Aryeh95/PaperAir/enclosure/README.md

# Enclosures

Three ways to house the PaperDIY with the sensors:

- **[Saddle](#saddle)** (recommended): the PaperDIY in M5Stack's own case, standing in a one-piece
  saddle with the sensors in a foot behind it. M5Stack's parts do all the fitting of the panel,
  board and buttons.
- **[Slim frame](#slim-frame)**: for the bare board and panel, without M5Stack's case. A thin
  printed frame around the screen. It fits the panel, but its built-in buttons never came right.
- **[Desk stand](#desk-stand)**: a low base that the cased PaperDIY stands in. Bulkier than the
  saddle.

Both need `kFlipScreen = true` in `include/config.h`, because the PaperDIY's buttons end up on top.

## Saddle

The PaperDIY in M5Stack's case, assembled the normal way, slides down into two rails at the
saddle's ends and leans back 13° against it, with a foot behind. Each rail is an end wall and a
2.5 mm flange over the bezel's face, 25 mm up from the bottom: the flanges stop the case tipping,
the end walls stop it sliding, gravity does the rest. Nothing screws the case to the saddle. The
rails' end walls are 3.2 mm thick. The left one has a groove inside for the power button's cap,
which it covers (the firmware doesn't use that button); the USB-C is above the rails. The foot is open underneath and closed by a bottom plate screwed on under the
whole saddle: the SEN66 goes in from below onto two posts on the plate, behind two grilles; the
SFA40 sits in a recess behind its own grille; the breakout goes between the four bosses the plate
screws to. Stick-on rubber feet under the plate. 127 × 44 × 65 mm with the case in it.

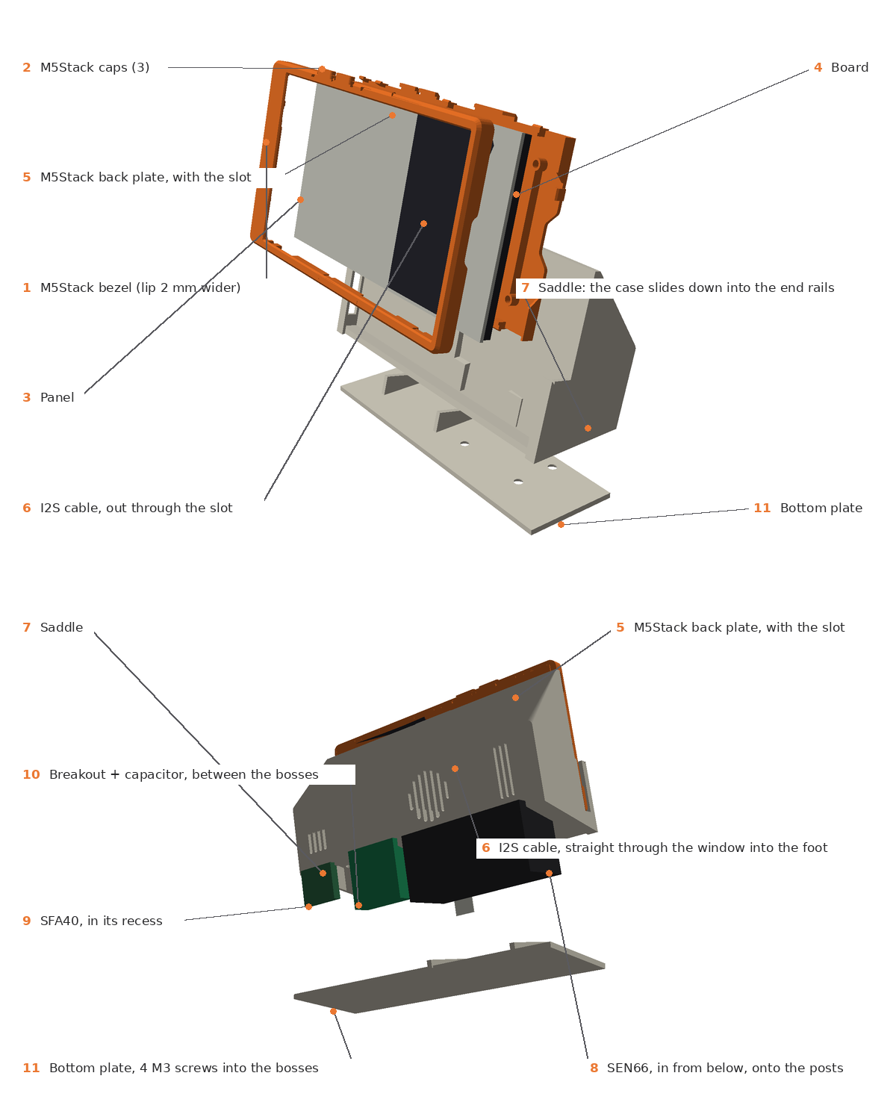
[picture p7: enclosure/render_saddle.png]
Exploded: the case front to back, and the saddle from behind with the foot's contents drawn out


| File | Print | Notes |
|---|---|---|
| M5Stack's three button caps | As M5Stack's | From [M5_Hardware](https://github.com/m5stack/M5_Hardware/tree/master/Products/K159-B_PaperDIY_Complete_Kit/Structures) (MIT licence, © M5Stack), unchanged |
| M5Stack's bezel, with a wider lip | Face down | `make_saddle.py --oem` also writes `paperdiy_bezel_lip.stl`: the lip reaches 2 mm further in all round, so the panel's black border stays covered. 18 pixels of the picture's margin go under it; the layout keeps 40 clear. The stock bezel works too, with a thin line of border showing. |
| M5Stack's back plate, with a slot | As M5Stack's | `python make_saddle.py --out stl --oem PaperDlY_Complete_Kit.stl` cuts an 11 × 14 mm slot over the board's I2S connector, so the FPC cable leaves straight out the back |
| `stl/saddle.stl` | Standing on its bottom edges, as exported | No supports: everything stands on the bed or grows from a wall at 45° or steeper. Four bosses inside the foot take M3 × 3 heat-set inserts (4.0 mm holes) from below. |
| `stl/saddle_bottom.stl` | As exported, posts up | No supports. The bottom plate: four M3 × 6 (or 8) countersunk screws into the bosses. Flat underneath for stick-on rubber feet. |

**Assembly:** press the four M3 × 3 inserts into the bosses inside the foot, from below. Build
M5Stack's case the way they do, bezel face down: caps in, panel in, board on, with the FPC cable
plugged into the I2S connector (the one at the board's inner edge, 5–15 mm from the buttons' edge)
and led out through the slot, then the back plate clipped on. Slide the case down into the rails,
buttons up, feeding the cable through the window in the saddle's face, which is straight behind the
slot, into the foot. Turn the whole thing over to load the foot: stick the SFA40 into its recess (can over the
grille) and the breakout to the back wall between the bosses, wire them as in [Wiring](#wiring),
then lay the SEN66 in between the end fins, grilles toward the back wall, and screw the bottom
plate on; its two posts hold the SEN66 up against the ledge. Stick rubber feet under the plate. Set `kFlipScreen = true`.

## Slim frame

The slim frame: front, back, with the back removed, and a section through the SEN66

- **Screen:** the panel sits behind a printed lip with no acrylic. The lip overlaps the picture by
  0.5 mm top and bottom and 0.3 mm at the ends (inside the screen's own margin), so none of the
  panel's black border shows. Small stops at the corners hold the glass in place.
- **Board:** sits behind the right-hand end of the glass and reaches 4.5 mm past it. Its end rests
  against the right-hand wall, and its two nubs sit in recesses that locate it across.
  - **Buttons:** G4 and G3 are pressed through two fingers in the top wall's outer skin, 8 mm long
    and fixed at one end, with a pad outside and a nub inside. About 0.7 N to click. No loose parts.
  - **Power switch:** the same, in the right-hand wall.
  - **USB-C:** opening on the right end, near the top.
- **Foot:** at the bottom-back, 28.5 mm deep, with a 45° shoulder up to the back plate. It holds:
  - **SEN66:** behind the left half of the glass, breathing through two grilles in the back.
  - **SFA40:** in a shallow recess in the back wall, behind the board, with its own grille.
  - **FPC breakout, its capacitor and the battery:** behind the board too, through an opening in
    the back plate there.
- **Board:** backed by the plate along its top edge and down its right-hand end, with foam tape
  between. The rest of the plate behind it is the opening into the foot.
- **Cable:** the FPC cable runs down inside, along the board's inner edge.
- **Sizes:** 125 wide × 68 tall × 36 deep. The screen part is 9 mm thick.

### Parts

| File | Print | Notes |
|---|---|---|
| `stl/frame_fit_test.stl` | **Print this first**, face down as exported | About an hour. See the checks below. |
| `stl/frame_bezel.stl` | Face down, as exported | No supports |
| `stl/frame_back.stl` | Standing on its bottom face, as exported | No supports. The bottom face is the flat one that sits on the desk; the split face is vertical. Nothing overhangs more than 45°. |
| `stl/frame_backer.stl` | Flat, as exported | Backing plate. The panel is flexible, so this holds it flat against the lip. It drops in; two ribs on the back hold it. |

### Fit test

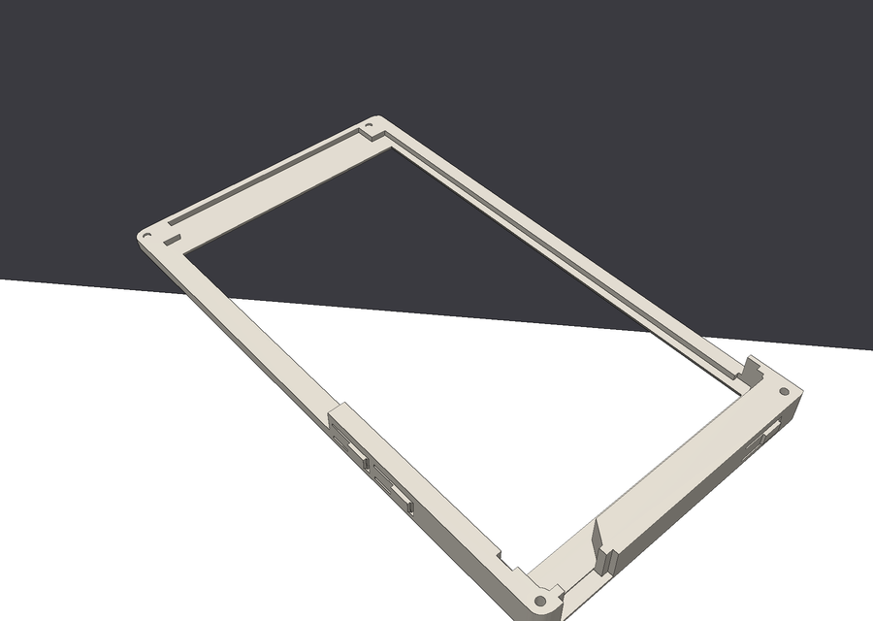
[picture p8: enclosure/render_fit_test.png]
The fit test as printed: a ring of the bezel's first 2.4 mm, full depth along the top and the right end


Drop the plugged-together panel and board into it, face down, then check:

1. **Pocket:** the glass drops in without forcing, with its left end between the two stops, and
   doesn't move. It has 0.25 mm to spare at each end and 0.15 above and below. Near the right end,
   the board has a small nub on each long edge. Each nub sits in its own recess, and the board's end
   touches the right-hand wall.
2. **Lip:** from the front, the lip covers the glass edge on all four sides but none of the
   picture beyond its outermost 5 pixels. Press G3 to flash the screen black and look at the
   edges. The picture is 4 mm from the glass's flex end and 1.5 mm from its board end, so the lip
   is wider on the left.
3. **Buttons:** press each of the three pads. Each should click its switch with a light press and
   spring back, and the screen shouldn't change unless you press. If a pad has to go in a long way
   before it clicks, the nub is short; if it clicks with no travel, it's long (`KEY_TIP_Y`,
   `PWR_TIP_X`).
4. **USB-C:** a cable plugs in fully.

If anything is off, tell me what you see, or change the measurement constants at the top of
`make_frame.py`. Each is labelled.

### Hardware

| Qty | Part |
|---|---|
| 4 | M2 × 6 screws, thread-forming ("PT") or plain M2 (they cut their own thread in the printed holes). The bottom-right one has no counterbore; its head stands proud. |
| 4 | 10 mm round rubber feet, 2 mm thick |
| — | Double-sided foam tape: 2 mm for a strip down the back of the board (it compresses to 1.7), 1 mm for the SFA40 board and the breakout |
| 1 | FPC cable, 12-way 0.5 mm, 150 mm, the same as for the stand, plus the breakout and capacitor (see Wiring) |

### Assembly

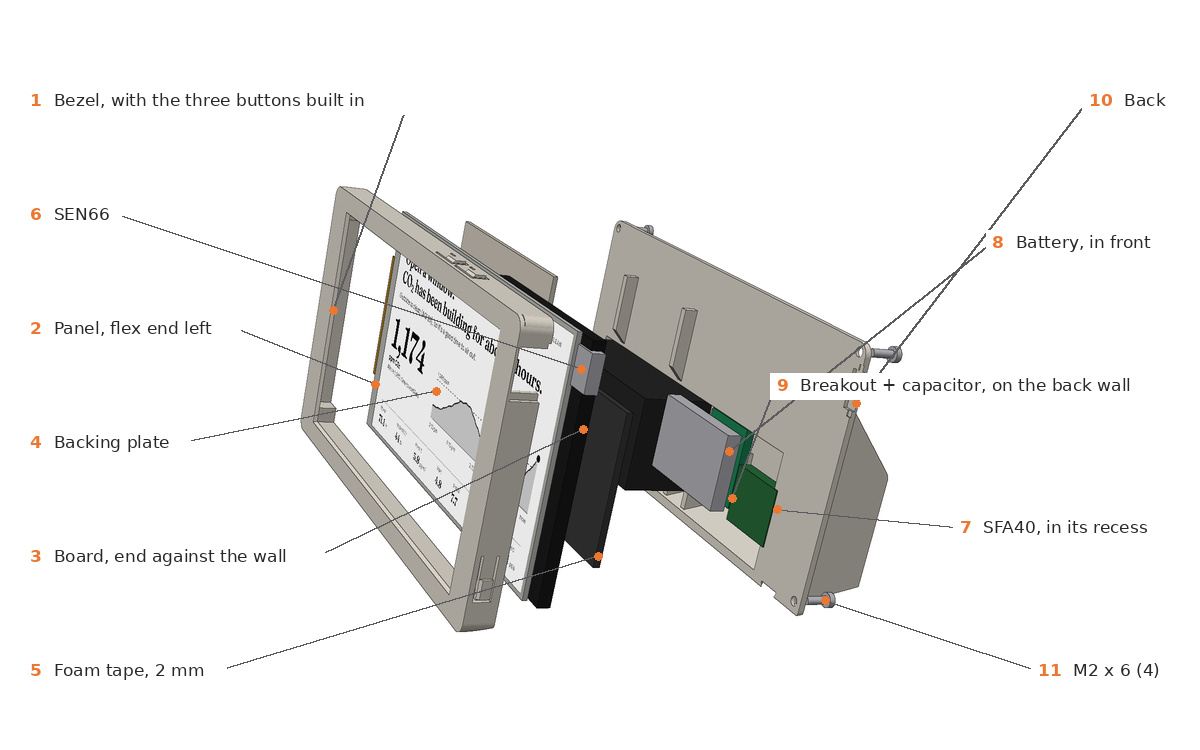
[picture p9: enclosure/render_exploded.png]
Exploded view: bezel and caps, panel and board, backing plate and foam tape, then the sensors, battery and breakout inside the back


1. Lay the panel face down in the bezel, with the board on the right-hand end. Plug the FPC cable
   into the board's FPC-I2S socket and the battery into its socket.
2. Drop the backing plate in behind the panel, left of the board, with its shallow channel over
   the panel's flex strip. It's loose until the back goes on; two ribs on the back then hold it
   against the panel.
3. Foam tape on the back of the board, 2 mm, in an L: a strip along its top edge and one down its
   right-hand end, on the tallest parts there (that's what the 4.7 mm stack was measured over). The
   back plate compresses it to 1.7 mm, which holds the board against the glass. Push the board's end
   against the right-hand wall before closing up: that's what lines its buttons up with their caps.
4. In the back part, deepest first:
   - Solder four wires to the SFA40's carrier board, then stick it into its recess in the back wall,
     can over the grille, solder pads toward the SEN66. It goes in through the opening behind the
     board.
   - Stick the breakout to the back wall beside it, capacitor already soldered across 3V3 and GND.
   - Lay the battery in the opening in front of them.
   - Slide the SEN66 in from the front: bottom edge onto the two fins, between the end fins, grilles
     against the back wall. Its top edge sits under the plate's edge and in the corner of the roof.
5. Run the FPC cable down along the board's inner edge, in the gap in front of the back plate, and
   into the opening to the breakout. Wire the sensors (see Wiring).
6. Close the back and fit the four screws. Stick the feet into their recesses.

The stiff part of the panel's flex reaches about 5 mm past the glass's left end. It lies flat between
the two stops at the left-hand corners, with room before the wall, and the flex loops up from it and
over the back of the panel to the board. The stops, and two at the right-hand corners, hold the glass
in place along its length. The board is a separate part, joined to the panel only by the flex, and
rests with its end against the right-hand wall.

### Measured, and worth checking

Most of the numbers come from M5Stack's dimension drawings of the panel, the board and the case,
and from the case model in
[M5_Hardware](https://github.com/m5stack/M5_Hardware/tree/master/Products/K159-B_PaperDIY_Complete_Kit),
checked against fit-test prints:
- the board's end, 4.46 mm past the glass, and its button, USB-C and power switch positions,
  measured from that end
- the two nubs on the board's long edges. They make it 64.2 mm across, against 62 mm for the glass
  (`NUBS_X`, `NUB_OUT`).
- the board's end: a tab at each corner stands proud of a recess between them, with 45° steps
  (calipers). The USB-C tab is 15 wide and 4 proud; the power-switch tab 15 wide and 3 proud. The
  USB-C tab is what rests against the end wall (`TAB_*`, `PWR_TAB_*`).
- the panel thickness, 1.2 mm. The backing plate and the ribs that hold it are set from it
  (`GLASS_T`).

From calipers and the fit tests:
- the glass, 110.5 × 62 mm (the drawing says 62.5; if yours is, `GLASS_H` in `make_frame.py`)
- the picture's position on the glass: 4 mm from the flex end, 1.5 mm from the board end
  (`ACTIVE_X`). This is the one to check first if the lip covers the picture or shows the border.
- the board's inner edge, and how far the button actuators stick out

The fit test checks all of them. The constants are at the top of `make_frame.py`.

## Desk stand

A low base that the PaperDIY stands in, leaning back 12°, with the SEN66 and the optional SFA40
inside it.

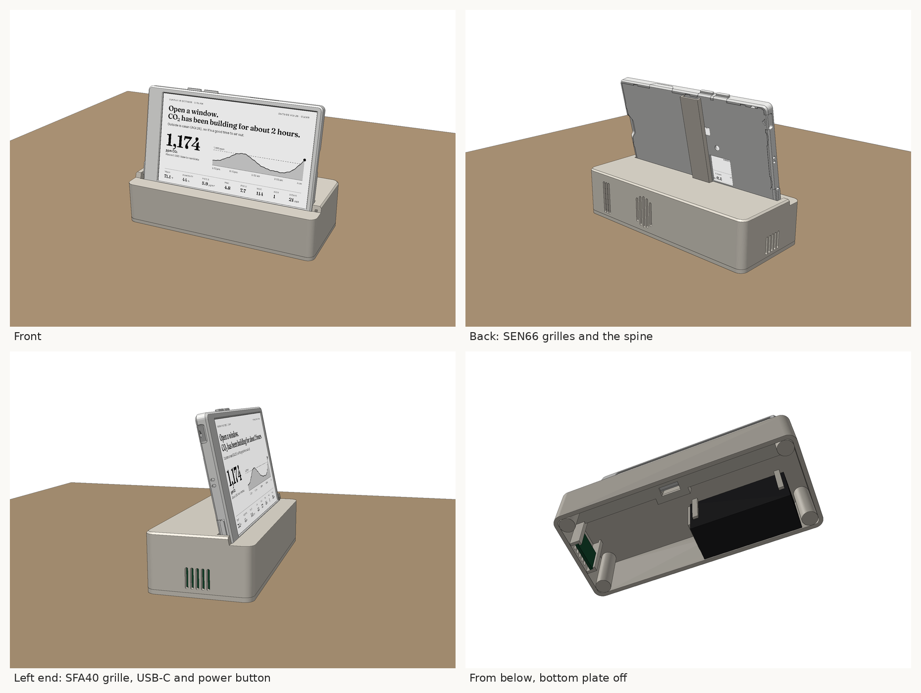
[picture p10: enclosure/render.png]
The stand: front, back, left end, and from below with the bottom plate off


- **The PaperDIY stands upside down** compared with how it ships, so its two buttons are on the
  top edge. The USB-C port and the power button end up on the left end. Set `kFlipScreen` in
  `include/config.h` if the picture comes out upside down.
  - Left button on the top edge: G3, full refresh.
  - Right button on the top edge: G4, switches between the main and trends pages.
- **The SEN66** lies against the back wall. It breathes through two grilles: the inlet at the right
  and the fan outlet in the middle. The solid wall between them keeps outlet air out of the inlet.
- **The SFA40** slides into a bay at the left end, sensor facing the small grille. It works by
  diffusion, so it needs no fan.
- **The FPC cable** connects the PaperDIY to the sensors:
  1. It leaves the PaperDIY through a slot in its back plate.
  2. It runs down a groove behind the PaperDIY, hidden by the spine.
  3. It drops through a hole in the slot floor into the base, where the breakout board sits loose
     in the front-left corner.
- **The front of the base steps down,** so the base doesn't hide the bottom row of readings.

Sizes: base 132 × 56 × 32 mm; with the PaperDIY in it, 91 mm tall.

### Parts

| File | Print | Notes |
|---|---|---|
| `stl/stand_base.stl` | Upside down, as exported | Turn on supports **touching the build plate only**. They're needed only under the 4 mm step at the front. Everything else (grilles, slot, ribs) prints without them. |
| `stl/stand_bottom.stl` | Flat, as exported | Countersunk holes and foot recesses face the bed |
| `stl/stand_spine.stl` | Flat on its back, as exported | Push it into the socket behind the slot. A drop of glue is optional. |
| back plate with FPC slot | Floor down, like M5Stack's | Generated from M5Stack's model; see below |

**Back plate.** Make it with
`python make_stand.py --out stl --oem PaperDlY_Complete_Kit.stl`, using M5Stack's model from
[M5_Hardware](https://github.com/m5stack/M5_Hardware/tree/master/Products/K159-B_PaperDIY_Complete_Kit/Structures)
(MIT licence, © M5Stack).

Alternatively, cut the slot into the back plate you have. It's 1.2 mm thick PLA, so a hobby
knife works. The slot is 5 × 13 mm. Seen from the screen side, with the case as it ships (buttons
on the bottom edge):
- 63.5–68.5 mm from the left edge
- 47.5–60.5 mm from the top edge

**Check the slot position before printing or cutting.** I worked it out from M5Stack's pinmap
photo, which I scaled using the ESP32 module. The board's other parts line up with the back
plate's windows to within about 1.5 mm. With the back off, the FPC-I2S connector should be 71–76 mm
from the left and 49–59 mm from the top, with its cable leaving towards the left. If yours is
elsewhere, change `BACKPLATE_SLOT` in `make_stand.py`.

### Hardware

| Qty | Part |
|---|---|
| 4 | M3 × 5.7 heat-set insert (4.4 mm holes, into the base's corner bosses from below) |
| 4 | M3 × 8 countersunk screw (bottom plate) |
| 4 | 10 mm round rubber feet (optional) |
| 1 | FPC cable, 12-way, 0.5 mm pitch, 150 mm. Which contact side you need depends on the breakout, so buy one of each ("A", same side, and "B", opposite sides); they're cheap. |
| 1 | FPC breakout board, 12-way 0.5 mm to 2.54 mm pins |
| 1 | 220 µF capacitor, 6.3 V or more (recommended, see below) |

## Wiring

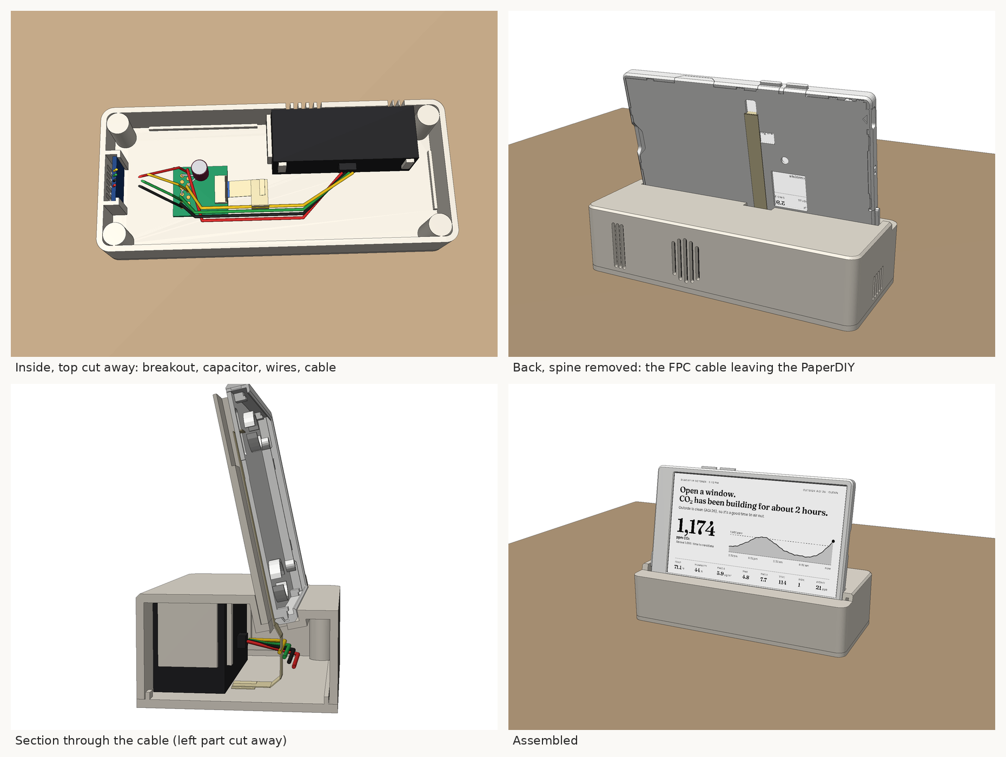
[picture p11: enclosure/render_wiring.png]
Inside the base, the cable route behind the PaperDIY, a section through the cable, and assembled


The cable goes into the **FPC-I2S** connector, the one nearer the buttons. On the PaperDIY's side:

| Pin | Signal | Goes to |
|---|---|---|
| 4 | G41 SYS_SDA | SDA on the SEN66 and SFA40 |
| 5 | G42 SYS_SCL | SCL on both |
| 2, 6 | GND | GND on both |
| 11, 12 | 3V3_AU | VDD on both |

- **Check the breakout's pin numbers before connecting the sensors.** A cable with contacts on
  opposite sides reverses the order.
  1. With the PaperDIY on USB, find the two neighbouring pins that read 3.3 V against a GND pin.
     Those are 11 and 12.
  2. Count the other pins from there.
- **3V3_AU** comes from its own 300 mA regulator, which is on whenever the PaperDIY has power.
  The SEN66 averages about 90 mA, but its fan and CO₂ sensor draw up to 350 mA in 2 ms bursts. So
  solder the 220 µF capacitor across 3V3 and GND on the breakout. Mind the polarity of an
  electrolytic capacitor.
- The bus already has pull-up resistors (it's shared with the PaperDIY's power chip), so the
  sensors need none.

### Changing the stand

Everything is set by the constants at the top of `make_stand.py`:
- the SEN66 and SFA40 sizes
- the slot clearance and lean
- the base size
- the insert hole size
- the back plate slot

Run `python make_stand.py --out stl` after a change (needs `pip install trimesh manifold3d numpy`).
