Aryeh95/PaperAir/preview/starting.png

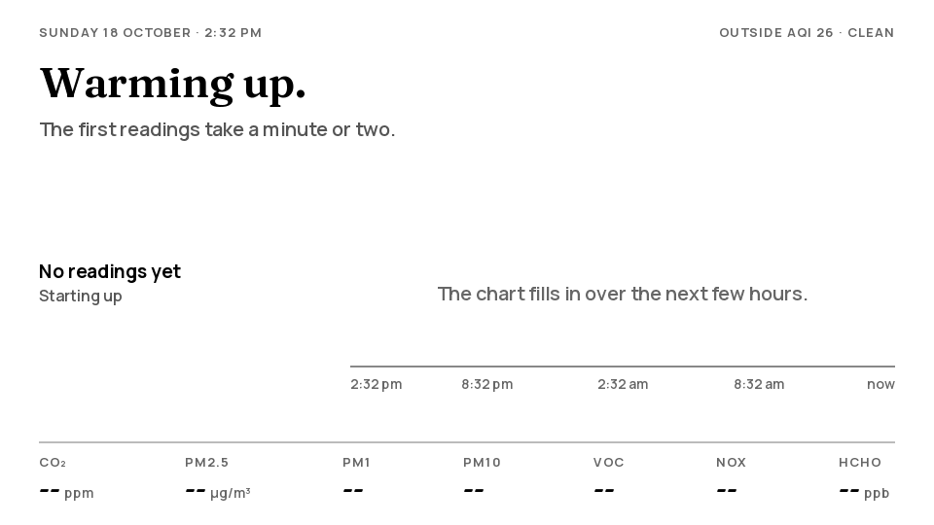
preview/starting.png
