Aryeh95/PaperAir/enclosure/stl/saddle.stl

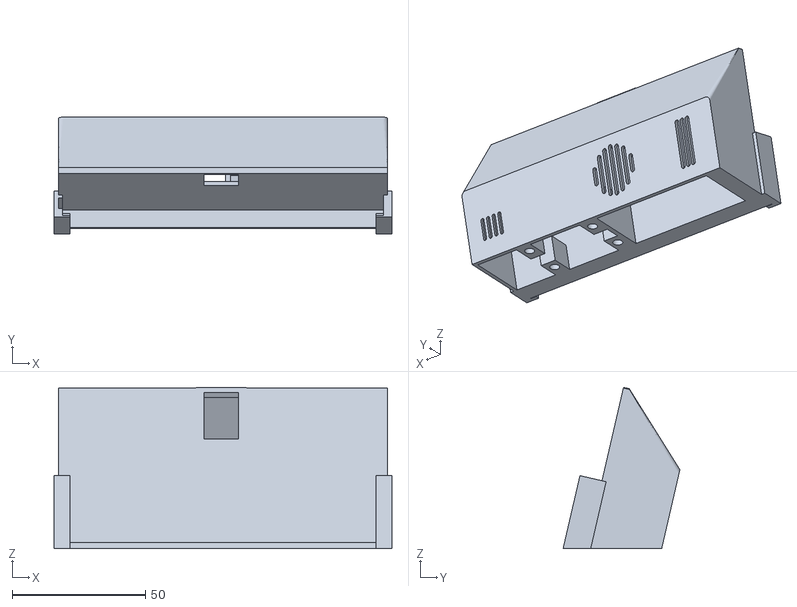
[picture p13: CAD file, 2026-11-10]
enclosure/stl/saddle.stl
127.0 x 43.9 x 60.6
