Aryeh95/PaperAir/enclosure/stl/saddle_bottom.stl

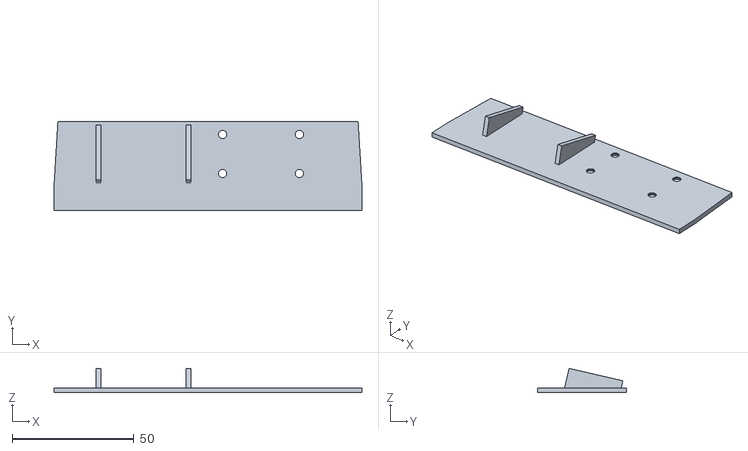
[picture p14: CAD file, 2026-11-10]
enclosure/stl/saddle_bottom.stl
126.4 x 36.4 x 9.96
