Aryeh95/PaperAir/enclosure/stl/frame_fit_test.stl

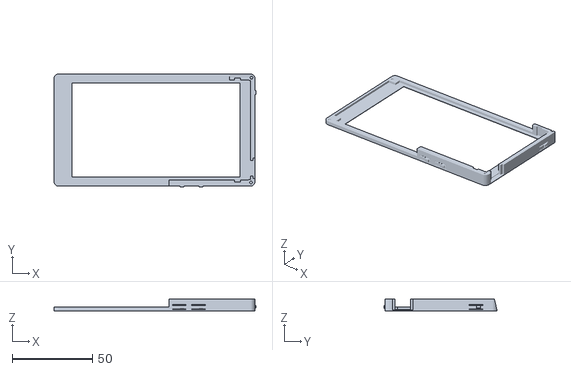
[picture p15: CAD file, 2026-10-28]
enclosure/stl/frame_fit_test.stl
125.8 x 70.6 x 7.40
