Aryeh95/PaperAir/enclosure/stl/frame_bezel.stl

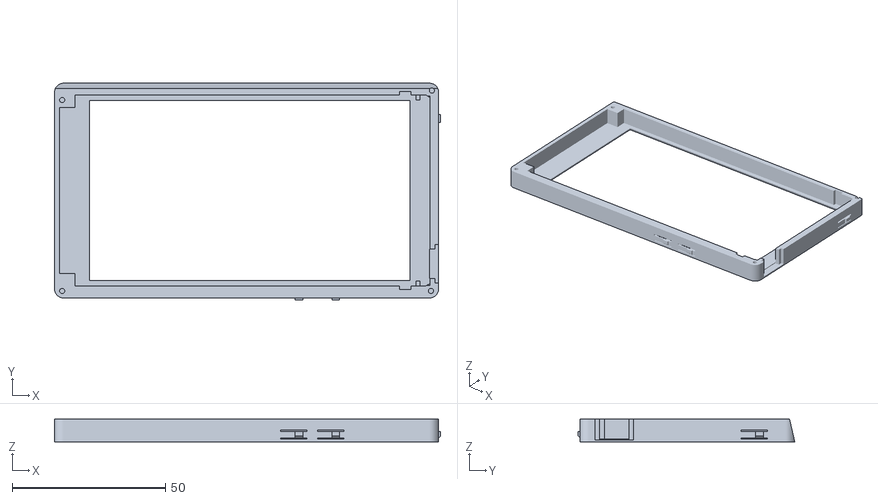
[picture p16: CAD file, 2026-10-28]
enclosure/stl/frame_bezel.stl
125.8 x 70.6 x 7.40
