Aryeh95/PaperAir/enclosure/stl/frame_back.stl

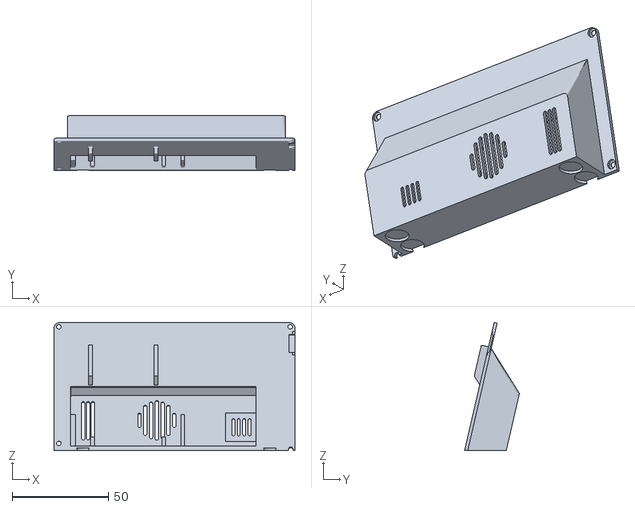
[picture p17: CAD file, 2026-10-28]
enclosure/stl/frame_back.stl
125.2 x 28.5 x 66.5
