Aryeh95/PaperAir/enclosure/stl/frame_backer.stl

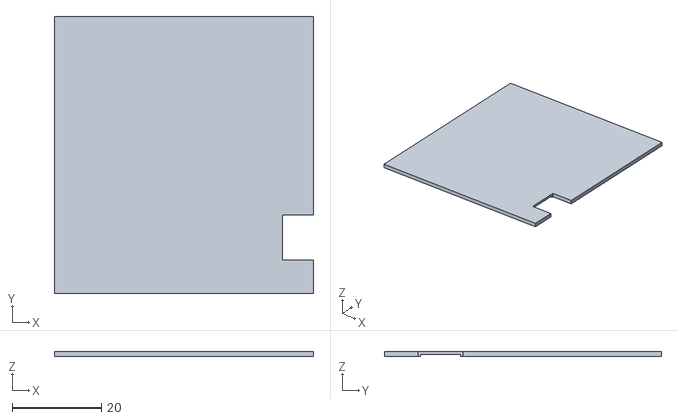
[picture p18: CAD file, 2026-10-28]
enclosure/stl/frame_backer.stl
58.1 x 62.1 x 1.20
