Aryeh95/PaperAir/enclosure/stl/stand_bottom.stl

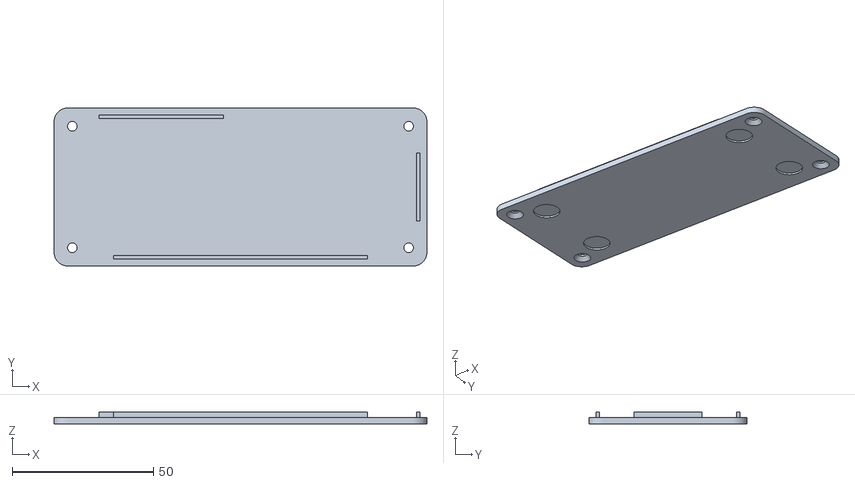
[picture p19: CAD file, 2026-10-18]
enclosure/stl/stand_bottom.stl
132.0 x 56.0 x 4.40
