Aryeh95/PaperAir/enclosure/stl/stand_base.stl

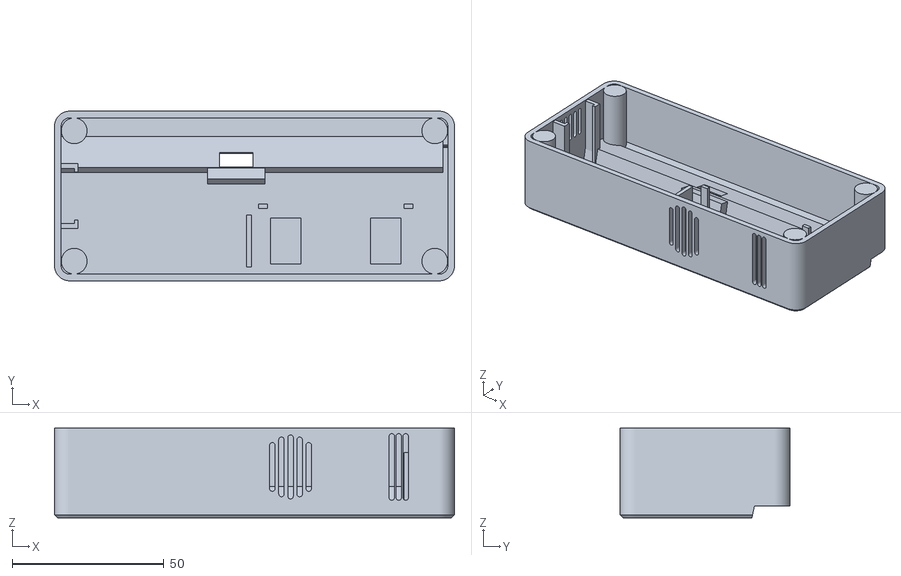
[picture p20: CAD file, 2026-10-18]
enclosure/stl/stand_base.stl
132.0 x 56.0 x 29.6
