Aryeh95/PaperAir/enclosure/stl/stand_spine.stl

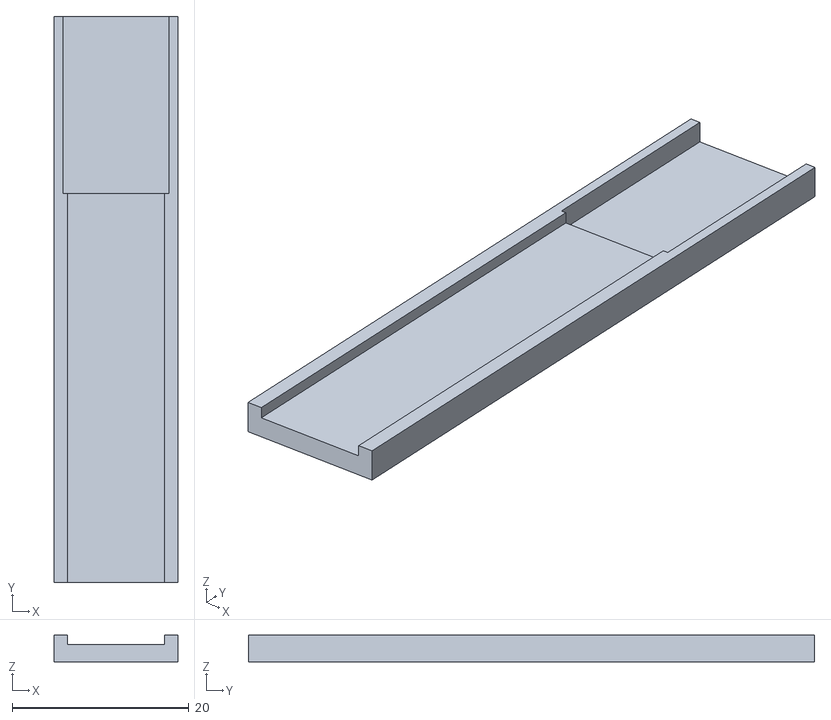
[picture p21: CAD file, 2026-10-18]
enclosure/stl/stand_spine.stl
14.0 x 64.0 x 3.00
