Aryeh95/PaperAir/enclosure/make_saddle.py

"""
Generates the saddle-foot for PaperAir: the PaperDIY in M5Stack's own case stands in it, leaning
back 13 degrees, with the SEN66, the optional SFA40, the FPC breakout and the battery in a foot
behind the case's lower half.

M5Stack's parts are used as they are (bezel, back plate, three button caps; MIT licence, in
M5_Hardware), except that the back plate gets a slot over the board's I2S connector, so the FPC
cable can leave the case. Pass M5Stack's STL with --oem to cut it; nothing of theirs is kept here.

Parts:
  saddle.stl              the saddle, open underneath. Printed standing on its bottom edges, as
                          exported, without supports: every part of it stands on the bed or grows
                          from a wall at 45 degrees or steeper. The assembled case slides down into
                          the two end rails; nothing screws the case to the saddle. The cable
                          window in its face is straight behind the back plate's slot.
  saddle_bottom.stl       the bottom plate, under the whole saddle: the sensors go in through
                          here. Four M3 countersunk screws into M3 x 3 heat-set inserts in the
                          bosses. Carries the two posts the SEN66 rests on. Printed as exported,
                          posts up, without supports.
  paperdiy_back_slot.stl  M5Stack's back plate with the cable slot (only with --oem). Printed as
                          M5Stack's.
  paperdiy_bezel_lip.stl  M5Stack's bezel with its lip 2 mm wider all round (--lip), so the panel's
                          black border stays covered. Printed face down, as exported.

Coordinates (mm), "local": X to the right seen from the front, Y down the screen (0 = the top edge
of the case, where the buttons are), Z into the case (0 = the bezel's front face). The saddle is then
leaned back and cut level where it meets the desk.

Usage:
  pip install trimesh manifold3d numpy
  python make_saddle.py --out stl [--oem PaperDlY_Complete_Kit.stl]
"""

import argparse
import math
import os

import numpy as np
import trimesh
from manifold3d import CrossSection, JoinType, Manifold, Mesh, OpType

SEG = 48

# --- M5Stack's case, from its model: 120 x 67 x 6.3, buttons on one long edge, USB-C on one end ---
CASE = (120.0, 67.0, 6.3)
CLR = 0.3                            # around the case in the saddle
# The I2S cable leaves its connector, passes under the display flex's fold and runs down the back
# of the panel, 5-15 mm from the buttons' edge (photo with the case open). The slot is in the back
# plate over the panel, just past the board's inner edge, so the cable turns straight out the back.
SLOT = (53.9, 64.9, 8.0, 22.0)       # x0, x1, y0, y1
# The same slot in M5Stack's coordinates (their model: buttons at -Y, USB-C at +X, front at Z -0.2)
# M5Stack's model to case coordinates: a half turn about Y. X local = 35.056 - X oem (their +X is
# to the left seen from the front), Y local = Y oem + 58.74, Z local = -(Z oem + 0.2).
OEM_XMAX, OEM_OFFSET = 35.056, (84.94, 58.74, -0.2)

# --- Saddle ---
WALL = 1.6
FRONT = 0.0                          # the floor's front edge: flush with the bezel's face. Nothing may stand in front of
                                     # the bezel, because it clips onto the back plate from the front after the plate is
                                     # screwed to the saddle
# The case is held by two rails at its ends: an end wall and a flange over the bezel's face, up
# from the floor. The assembled case slides down into them from the top; gravity and the 13 degree
# lean keep it against the saddle, the flanges stop it tipping, the end walls stop it sliding.
# The left end (seen from the front) has the USB-C high up, above the rails, and the power
# button's cap low down, which protrudes 1.2 mm: a groove down the inside of the left end wall
# clears it. The groove does not go through, so the wall stays in one piece (the button is covered).
RAIL_H = 25.0                        # up from the case's bottom edge
FLANGE_W, FLANGE_T = 2.5, 1.6        # over the bezel's face at each end (its frame is 3.5 wide at the right end)
RAIL_EXTRA = 1.6                     # the rails' end walls are this much thicker than the foot's, outward: 3.2 mm in all
POWER_CAP = (64.5, 1.5, 5.5)         # y1, z0, z1 of the slot for the power button's cap: open from the rail's top down to y1, so the cap can slide in
FLOOR = 2.4                          # under the case at the front (rubber feet sit in it)
TILT = math.radians(13)
T_THIN = CASE[2] + CLR + 2.4         # the thin part behind the case, at the top of the foot's shoulder
CABLE_BELOW = 4.0                    # the cable window in the face reaches this far below the back plate's slot

# --- Foot ---
SEN = (55.0, 26.0, 21.2)             # SEN66: length (X), width (Y), depth (Z)
SEN_X0 = 6.0
SEN_Z0 = CASE[2] + CLR + WALL + 3.0  # 3 mm in front of it for the cable and wires
T_FOOT = SEN_Z0 + SEN[2] + 0.2 + WALL
SFA = (17.3, 15.2, 3.6)              # SFA40 carrier board, 16.9 x 14.8 x 3.4 measured, plus clearance
SFA_RECESS = 0.6

INSERT_HOLE = 4.0                    # for M3 heat-set inserts

# The bottom plate: 2 mm, screwed on under the whole saddle (everything of the saddle stands on the
# printer's bed, so it prints without supports). Four countersunk M3 screws go up into M3 x 3
# inserts (4.0 mm holes) in four bosses that stand on the bed against the front and back walls, in
# the free space between the SEN66 and the SFA40.
PLATE = 2.0
PLATE_CLR = 0.3                      # the plate's outline, in from the saddle's footprint
BEAM_X = (66.0, 97.5)                # boss centres, 7 wide: between the SEN66 (ends at 61) and the SFA40 (starts at 101.5)
BEAM_W, BOSS_D, BOSS_H = 7.0, 9.0, 10.0
BOTTOM_INSERT_DEPTH = 4.0            # M3 x 3 inserts, with a little room above them
BOTTOM_SCREW_IN = 4.5                # the holes, in from the front and back walls

X0, X1 = -CLR - WALL, CASE[0] + CLR + WALL
Y1 = CASE[1] + CLR + FLOOR           # where the saddle's front-bottom edge meets the desk


# ---------------------------------------------------------------------------------------------
def box(x0, x1, y0, y1, z0, z1):
    return Manifold.cube([x1 - x0, y1 - y0, z1 - z0]).translate([x0, y0, z0])


def rr(x0, x1, y0, y1, r):
    r = min(r, (x1 - x0) / 2 - 0.01, (y1 - y0) / 2 - 0.01)
    return CrossSection.square([x1 - x0 - 2 * r, y1 - y0 - 2 * r]).translate([x0 + r, y0 + r]).offset(
        r, JoinType.Round, circular_segments=SEG)


def prism(section, z0, z1):
    return section.extrude(z1 - z0).translate([0, 0, z0])


def union(parts):
    return Manifold.batch_boolean(parts, OpType.Add)


_d = np.array([0, -math.sin(TILT), -math.cos(TILT)])   # down the face
_n = np.array([0, math.cos(TILT), -math.sin(TILT)])    # into the case
TO_WORLD = np.c_[[1, 0, 0], _d, _n, -Y1 * _d]
TO_LOCAL = np.linalg.inv(np.vstack([TO_WORLD, [0, 0, 0, 1]]))[:3]


def world(m):
    return m.transform(TO_WORLD)


def local(m):
    return m.transform(TO_LOCAL)


def above_desk(m, z=0.0):
    return local(world(m) ^ box(-1000, 1000, -1000, 1000, z, 1000))


def SEN_Y0():
    """The SEN66's top edge, as high as needed for its bottom corner to clear the floor."""
    z_back = SEN_Z0 + SEN[2]
    y_floor_back = Y1 - math.tan(TILT) * z_back - FLOOR / math.cos(TILT)
    return y_floor_back - 0.5 - SEN[1]


def sensor_box():
    y0 = SEN_Y0()
    return (SEN_X0, SEN_X0 + SEN[0], y0, y0 + SEN[1], SEN_Z0, SEN_Z0 + SEN[2])


def sfa_box():
    x1 = X1 - WALL - 1.5
    y1 = SEN_Y0() + SEN[1] - 2
    return (x1 - SFA[0], x1, y1 - SFA[1], y1, T_FOOT - WALL - SFA[2] - 0.2, T_FOOT - WALL - 0.2)


def grille(xs, y0, y1, w=1.8):
    holes = []
    for x in xs:
        sec = CrossSection.square([w, y1 - y0 - w]).translate([x - w / 2, y0 + w / 2])
        sec = sec + CrossSection.circle(w / 2, SEG).translate([x, y0 + w / 2]) + CrossSection.circle(w / 2, SEG).translate([x, y1 - w / 2])
        holes.append(prism(sec, T_FOOT - WALL - 1, T_FOOT + 1))
    return union(holes)


def build():
    zf = CASE[2] + CLR                                   # the case's back face, plus clearance
    step_y = SEN_Y0() - WALL - 0.3                       # the foot's top, at the back
    rise = T_FOOT - T_THIN
    # The foot, with a 45 degree shoulder up to the thin part, and the thin part itself up to the slot
    lower = prism(rr(X0, X1, step_y, Y1 + 30, 2.0), zf, T_FOOT)
    upper = prism(rr(X0, X1, step_y - rise, step_y - rise + 0.5, 0.2), zf, T_THIN)
    s = Manifold.batch_hull([lower, upper])
    s += box(SLOT[0] - 4, SLOT[1] + 4, SLOT[2] - 2, step_y, zf, T_THIN)
    # The floor under the case (its front edge flush with the bezel's face), and the two rails: an
    # end wall each, and a flange in front of the bezel's face at the end
    s += box(X0, X1, CASE[1] + CLR, Y1 + 30, FRONT, T_FOOT)
    z_flange = -CLR - FLANGE_T
    y_rail = CASE[1] - RAIL_H
    xl, xr = X0 - RAIL_EXTRA, X1 + RAIL_EXTRA
    s += box(xl, X0 + WALL, y_rail, Y1 + 30, z_flange, zf + WALL)                  # left end wall
    s += box(X1 - WALL, xr, y_rail, Y1 + 30, z_flange, zf + WALL)                  # right end wall
    s += box(xl, FLANGE_W, y_rail, Y1 + 30, z_flange, -CLR)                        # left flange, down to the bed
    s += box(CASE[0] - FLANGE_W, xr, y_rail, Y1 + 30, z_flange, -CLR)              # right flange
    # A lead-in on the flanges' top inner edge, so the case finds its way in
    for xa, xb in ((X0 + WALL, FLANGE_W + 1), (CASE[0] - FLANGE_W - 1, X1 - WALL)):
        s -= Manifold.batch_hull([box(xa, xb, y_rail - 1, y_rail + 0.01, -CLR - 1, -CLR + 0.01),
                                  box(xa, xb, y_rail + 1, y_rail + 1.01, -CLR - 0.01, -CLR + 0.01)])
    # The groove inside the left end wall for the power button's cap, from the top of the rail down
    s -= box(X0, X0 + WALL + 1, y_rail - 1, POWER_CAP[0], POWER_CAP[1], POWER_CAP[2])
    # The cavity, with the same shoulder inside
    step_i = SEN_Y0() - 0.3
    inner = cavity()
    s -= inner                                           # open underneath: the bottom plate closes it
    # The cable: a window through the face straight behind the back plate's slot, into the cavity
    # (which reaches up behind it under the shoulder). Its top slopes at 45 degrees, to print.
    xa, xb, ya, yb = SLOT[0] - 1, SLOT[1] + 1, SLOT[2], SLOT[3] + CABLE_BELOW
    s -= Manifold.batch_hull([box(xa, xb, ya, yb, zf - 0.01, zf),
                              box(xa, xb, ya + WALL + 0.11, yb, zf + WALL + 0.09, zf + WALL + 0.1)])
    # SEN66: inlet grille at its left end, fan outlet in the middle, fins that hold it
    x0, x1, y0, y1, z0, z1 = sensor_box()
    s -= grille([x0 + 3.2 + 1.0, x0 + 6.7, x0 + 10.2 - 1.0], y0 + 2.8, y1 - 2.8)
    xc, yc, r = x0 + 42.4, y0 + 12.8, 10.6
    slots = []
    for k in range(-3, 4):
        x = xc + 3.0 * k
        h = math.sqrt(max(0.0, r * r - (abs(x - xc) + 0.9) ** 2))
        if h > 2:
            slots.append(grille([x], yc - h, yc + h))
    s -= union(slots)
    zw = T_FOOT - WALL + 0.5
    fins = [box(X0 + WALL - 0.5, x0 + 0.15, y0 + 14, Y1 + 40, zf + 1, zw),
            box(x1 - 0.15, x1 + 1.85, y0 + 14, Y1 + 40, zf + 1, zw)]
    ledge = Manifold.batch_hull([box(x0 + 3, x1 - 3, y0 - 2.5, y0 + 0.15, zw - 0.01, zw),   # along the back wall, above it
                                 box(x0 + 3, x1 - 3, y0 - 2.5, y0 - 2.35, zw - 2.65, zw)])
    s += above_desk(union(fins) + ledge, 0)              # the fins stand on the bed
    # SFA40: a shallow recess in the back wall and its grille
    sx0, sx1, sy0, sy1, sz0, sz1 = sfa_box()
    s -= Manifold.batch_hull([box(sx0, sx1, sy0, sy1, sz1 - 0.01, sz1),                  # its top edge at 45 degrees
                              box(sx0, sx1, sy0 + SFA_RECESS, sy1, sz1 + SFA_RECESS - 0.01, sz1 + SFA_RECESS)])
    s -= grille([sx0 + 4 + 2.8 * k for k in range(4)], sy0 + 3, sy1 - 3, 1.5)
    # The four bosses the bottom plate screws to: on the bed, against the front and back walls,
    # leaning with them. Insert holes from below.
    for bx in BEAM_X:
        for za, zb in ((zf + WALL - 0.6, zf + WALL + BOSS_D), (T_FOOT - WALL - BOSS_D, T_FOOT - WALL + 0.6)):
            boss = box(bx - BEAM_W / 2, bx + BEAM_W / 2, 0, Y1 + 40, za, zb)
            s += local(world(boss) ^ box(-1000, 1000, -1000, 1000, 0, BOSS_H))
        for (hx, hy) in bottom_screws(bx):
            r = INSERT_HOLE / 2                          # the hole for the insert, then a narrower one for the screw's tip, each with a conical top
            s -= local(Manifold.cylinder(BOTTOM_INSERT_DEPTH + 1.0, r, circular_segments=SEG).translate([hx, hy, -0.5]))
            s -= local(Manifold.cylinder(r - 1.3, r, 1.3, circular_segments=SEG).translate([hx, hy, BOTTOM_INSERT_DEPTH + 0.49]))
            s -= local(Manifold.cylinder(BOSS_H - 3.0, 1.3, circular_segments=SEG).translate([hx, hy, -0.5]))
            s -= local(Manifold.cylinder(1.3, 1.3, 0.01, circular_segments=SEG).translate([hx, hy, BOSS_H - 3.51]))
    # Level with the desk
    return local(world(s) ^ box(-1000, 1000, -1000, 1000, 0, 1000))


def world_y(zl, zw):
    """World Y of the local plane z = zl at world height zw."""
    yl = (zw - _n[2] * zl + Y1 * _d[2]) / _d[2]
    return _d[1] * yl + _n[1] * zl - Y1 * _d[1]


def bottom_screws(bx):
    """World (x, y) of the two screw holes in the beam at local x = bx: in from each wall."""
    zf = CASE[2] + CLR
    return ((bx, world_y(zf + WALL, 2.5) + BOTTOM_SCREW_IN), (bx, world_y(T_FOOT - WALL, 2.5) - BOTTOM_SCREW_IN))


def cavity():
    """The foot's cavity, in local coordinates, as cut from the saddle (open to the desk)."""
    zf = CASE[2] + CLR
    step_i = SEN_Y0() - 0.3
    rise_i = (T_FOOT - WALL) - (zf + WALL)
    inner_lower = prism(rr(X0 + WALL, X1 - WALL, step_i, Y1 + 30, 0.8), zf + WALL, T_FOOT - WALL)
    inner_upper = prism(rr(X0 + WALL, X1 - WALL, step_i - rise_i, step_i - rise_i + 0.5, 0.2), zf + WALL, zf + WALL + 0.01)
    return Manifold.batch_hull([inner_lower, inner_upper])


def build_bottom():
    """The bottom plate, in world coordinates, under the saddle (z from -PLATE to 0): the saddle's
    footprint less a little, 2 mm thick, with the SEN66's two posts and the screw holes. Flat
    underneath, for stick-on rubber feet."""
    zf = CASE[2] + CLR
    outline = world(build()).slice(0.05).hull().offset(-PLATE_CLR, JoinType.Round, circular_segments=SEG)
    p = outline.extrude(PLATE).translate([0, 0, -PLATE])
    # The SEN66 rests on two posts, up to its bottom edge (a plane leaning with the case)
    x0, x1, y0, y1, z0, z1 = sensor_box()
    zw = T_FOOT - WALL - 0.7
    for px in (x0 + 8, x1 - 10):
        p += world(box(px, px + 2, y1 + 0.15, Y1 + 40, zf + WALL + 1.0, zw)) ^ box(-1000, 1000, -1000, 1000, -0.01, 100)
    # Countersunk screw holes (90 degrees, heads flush)
    for bx in BEAM_X:
        for (hx, hy) in bottom_screws(bx):
            p -= Manifold.cylinder(PLATE + 2, 1.7, circular_segments=SEG).translate([hx, hy, -PLATE - 1])
            p -= Manifold.cylinder(1.6, 3.3, 1.7, circular_segments=SEG).translate([hx, hy, -PLATE - 0.01])
    return p


def oem_back_with_slot(path):
    """M5Stack's back plate (the second-largest part of their kit model) with the cable slot."""
    kit = trimesh.load(path)
    parts = sorted(kit.split(only_watertight=False), key=lambda p: -p.volume)
    back = next(p for p in parts if p.bounds[1][2] < -2 and (p.bounds[1][0] - p.bounds[0][0]) > 100 and p.bounds[0][1] < 10)   # the assembled copy
    m = Manifold(Mesh(vert_properties=np.asarray(back.vertices, np.float32), tri_verts=np.asarray(back.faces, np.uint32)))
    x0, x1 = OEM_XMAX - SLOT[1], OEM_XMAX - SLOT[0]
    y0, y1 = SLOT[2] - OEM_OFFSET[1], SLOT[3] - OEM_OFFSET[1]
    m -= box(x0, x1, y0, y1, -20, 20)
    return m


def oem_bezel_with_lip(path, extra):
    """M5Stack's bezel with its window lip reaching `extra` mm further in on all four sides, so the
    panel's black border stays covered. The lip's 45 degree chamfer is kept. Returned face down."""
    kit = trimesh.load(path)
    parts = sorted(kit.split(only_watertight=False), key=lambda p: -p.volume)
    bez = next(p for p in parts if p.bounds[1][2] > -1 and (p.bounds[1][0] - p.bounds[0][0]) > 100 and p.bounds[0][1] < 10)   # the assembled copy
    m = Manifold(Mesh(vert_properties=np.asarray(bez.vertices, np.float32), tri_verts=np.asarray(bez.faces, np.uint32)))
    # The stock window, in M5Stack's coordinates: front face at z -0.2, the lip 0.8 thick with a
    # 0.6 chamfer on its front edge, the panel pocket behind it
    wx0, wx1, wy0, wy1 = -81.45, 23.56, -55.10, 4.62
    cham, z_front, z_back = 0.6, -0.2, -1.0
    outer = box(wx0 - 2, wx1 + 2, wy0 - 2, wy1 + 2, z_back, z_front)   # overlaps the stock lip, fills its chamfer
    hole = Manifold.batch_hull([box(wx0 + extra, wx1 - extra, wy0 + extra, wy1 - extra, z_back - 1, z_front - cham),
                                box(wx0 + extra - cham, wx1 - extra + cham, wy0 + extra - cham, wy1 - extra + cham, z_front - 0.01, z_front)])
    hole += box(wx0 + extra - cham, wx1 - extra + cham, wy0 + extra - cham, wy1 - extra + cham, z_front - 0.01, z_front + 1)
    return (m + (outer - hole)).rotate([180, 0, 0])


# ---------------------------------------------------------------------------------------------
def to_trimesh(m):
    mesh = m.to_mesh()
    return trimesh.Trimesh(vertices=np.asarray(mesh.vert_properties)[:, :3], faces=np.asarray(mesh.tri_verts))


def main():
    ap = argparse.ArgumentParser(description=__doc__, formatter_class=argparse.RawDescriptionHelpFormatter)
    ap.add_argument("--out", default="stl")
    ap.add_argument("--oem", help="M5Stack's PaperDlY_Complete_Kit.stl, to cut the slot into its back plate")
    ap.add_argument("--lip", type=float, default=2.0, help="with --oem: also make a bezel whose lip reaches this much further in (mm)")
    args = ap.parse_args()
    os.makedirs(args.out, exist_ok=True)
    s = build()
    print(f"saddle: {s.volume():.0f} mm^3, {s.status()}, genus {s.genus()}")
    w = world(s)
    t = to_trimesh(w)
    shift = -t.bounds[0]
    t.apply_translation(shift)
    t.export(os.path.join(args.out, "saddle.stl"))
    bb = w.bounding_box()
    print(f"saddle: {bb[3] - bb[0]:.1f} wide, {bb[4] - bb[1]:.1f} deep, {bb[5] - bb[2]:.1f} tall")
    p = build_bottom()
    tp = to_trimesh(p)
    tp.apply_translation([shift[0], shift[1], -tp.bounds[0][2]])   # on the bed, lined up with saddle.stl in X and Y
    tp.export(os.path.join(args.out, "saddle_bottom.stl"))
    pb = p.bounding_box()
    print(f"bottom plate: {p.volume():.0f} mm^3, {p.status()}, {pb[3] - pb[0]:.1f} x {pb[4] - pb[1]:.1f} x {pb[5] - pb[2]:.1f}")
    if args.oem:
        b = oem_back_with_slot(args.oem)
        t = to_trimesh(b)
        t.export(os.path.join(args.out, "paperdiy_back_slot.stl"))
        print(f"back plate with slot: {b.volume():.0f} mm^3, {b.status()}")
        if args.lip > 0:
            z = oem_bezel_with_lip(args.oem, args.lip)
            t = to_trimesh(z)
            t.apply_translation(-t.bounds[0])
            t.export(os.path.join(args.out, "paperdiy_bezel_lip.stl"))
            print(f"bezel with a {args.lip} mm wider lip: {z.volume():.0f} mm^3, {z.status()}")


if __name__ == "__main__":
    main()
