Aryeh95/PaperAir/enclosure/make_frame.py

"""
Generates the slim frame for PaperAir: the bare PaperDIY panel and board (no M5Stack case) in a
thin printed frame that leans back 13 degrees, with a foot at the bottom-back that holds the
SEN66, the optional SFA40, the FPC breakout and the battery.

Parts (all print without supports):
  frame_bezel.stl     front face down. The printed lip holds the glass. The board's two buttons and
                      its power switch are pressed through fingers cut into the top and right walls,
                      each fixed at one end, with a pad outside and a nub inside; the USB-C has an
                      opening in the right wall.
  frame_back.stl      the back plate and the sensor foot, standing on its bottom face (the one that
                      sits on the desk), so the back wall and the foot print as walls, not a ceiling.
  frame_backer.stl    a flat plate behind the panel, which is flexible: it holds it flat against the
                      lip. Printed flat; its edges clip into grooves in the bezel.
  frame_fit_test.stl  the first 2.4 mm of the bezel all round, plus its top right corner at full
                      depth: shows the lip, the pocket, the buttons and the USB-C opening in
                      about an hour.

The PaperDIY sits upside down compared with how it ships, so its buttons are on top: set
kFlipScreen = true in include/config.h.

Coordinates (mm), "local" frame: X to the right seen from the front, Y down the screen (0 = the
top edge of the glass), Z into the frame (0 = the front face). The frame is then leaned back and
cut level where it meets the desk.

Usage:
  pip install trimesh manifold3d numpy
  python make_frame.py --out stl/
"""

import argparse
import math
import os

import numpy as np
import trimesh
from manifold3d import CrossSection, JoinType, Manifold, Mesh, OpType

SEG = 48

# --- Panel and board. From M5Stack's dimension drawings and case model (K159-B in M5_Hardware),
# checked against the fit tests; see enclosure/README.md ---
GLASS_W, GLASS_H = 110.5, 62.0       # ED047TC1 glass, without the flex stub at its left end (calipers; drawing 110.54 x 62.5)
STUB = 4.8                           # the stiff part of the flex, past the glass's left end (drawing: 4.76 x 34.5)
ACTIVE_W, ACTIVE_H = 105.02, 59.72   # the picture
ACTIVE_X = 4.03                      # from the glass's left end: the wide border is at the flex end (fit tests v1, v5, v8)
ACTIVE_Y = (GLASS_H - ACTIVE_H) / 2  # centred across
STACK = 4.7                          # glass plus board, front of glass to back of board (calipers)
GLASS_T = 1.2
# The board sits behind the right-hand end of the glass and reaches past it. Along the frame it is
# located by its end, which rests against the right-hand wall; across, by its two nubs.
BOARD_END = GLASS_W + 4.46           # the board's end, past the glass's right-hand edge
BOARD_X0 = BOARD_END - 51.4          # its inner edge (fit test)
BOARD_W = 61.15                      # across, without the nubs; centred on the glass
BOARD_TOP = (GLASS_H - BOARD_W) / 2
# Board edge features, in this orientation (buttons on top), from the board's end and top edge
KEYS_X = (BOARD_END - 42.3, BOARD_END - 30.3)   # G4, G3 centres along the top edge (fit test v9)
ACTUATOR = 1.5                       # all three switch actuators stick out this far past the board's edge (calipers)
KEY_TIP_Y = BOARD_TOP - ACTUATOR     # the button actuators' tips
KEY_Z = 2.4                          # their centre, measured from the front face (fit test v7)
USB_Y, USB_Z = BOARD_TOP + 6.73, 3.4   # USB-C centre on the right end (fit test v9)
USB_TIP_X = BOARD_END + 2.05         # its socket stands out past the tab
PWR_Y, PWR_Z = BOARD_TOP + BOARD_W - 7.1, KEY_Z   # power switch centre on the right end (fit test v7)
# The board's end is not straight: a tab at each corner stands proud of the edge between them. The
# USB-C tab is the longest reach and rests against the end wall. The sizes here only set the clearance
# cuts in the corner columns and where the power switch's actuator ends; the wall itself is plain.
TAB_W, TAB_OUT, TAB_STEP = 15.0, 4.0, 3.0            # USB-C corner: width, proud of the recessed edge, step
PWR_TAB_W, PWR_TAB_OUT, PWR_TAB_STEP = 15.0, 3.0, 4.0   # power-switch corner
PWR_TIP_X = BOARD_END - TAB_OUT + PWR_TAB_OUT + ACTUATOR   # the power switch's actuator tip, past its tab
NUBS_X = (BOARD_END - 8.56, BOARD_END - 6.84)   # two nubs, one on each long edge, near the right end (drawing: 6.84 from the end, 1.72 long)
NUB_FIT = 1.0                        # clearance at each end of a nub's recess (the tab locates the board along the frame)
CORNER_CHAMFER = 1.0
NUB_OUT = (64.2 - GLASS_H) / 2       # how far they reach beyond the glass: 64.2 mm across both
FPC_EXIT = (BOARD_X0, 7.0, 16.0)     # FPC-I2S cable leaves from under the board's inner edge, Y range
FLEX_Y = (9.0, 16.0)                 # the panel's own flex strip runs along its back, tab to board

# --- Backing plate: the panel is flexible, so a flat plate behind it (left of the board) keeps it
# flat against the lip. It drops into the pocket; two ribs on the back hold it there. ---
BACKER_T = 1.2
BACKER_X = (4.0, BOARD_X0 - 1.5)     # clear of the flex stub's bond on the glass, and of the board's connectors
BACKER_RIBS_X = (12.0, 46.0)         # the ribs' centres along the frame; they reach forward from the back plate
BACKER_NOTCH = 7.0                   # the plate stops this far short of the board over the flex, which rises there to the board's connector

# --- Frame ---
LIP = 1.0                            # thickness of the printed lip in front of the glass
CLEAR = 0.25                         # at each end of the glass in its pocket (fit test v9: no play to speak of)
CLEAR_Y = 0.15                       # above and below it (fit test v10: 0.25 left a little play)
WINDOW_MARGIN = -0.3                 # the lip overlaps the picture at each end by 0.3 mm (3 pixels)
WINDOW_MARGIN_Y = -0.5               # and top and bottom by 0.5 mm (fit test v10: 0.3 still showed the border)
CHAMFER = 0.4                        # the lip's front edge, so the window doesn't shadow the picture
X0, X1 = -STUB - 0.6 - 1.6, BOARD_END + 3.2   # outer: the flex stub lies flat past the glass on the left, USB-C on the right
STOP = 4.0                           # stops at the glass's corners hold it in place along X; the flex
                                     # tab and its fold are between the stops at the left end
Y0, Y1 = -4.0, GLASS_H + 4.0
RADIUS = 3.0
WALL = 1.6
ZS = 7.4                             # where the bezel and the back meet
T_THIN = ZS + 1.6                    # thickness of the screen part
TILT = math.radians(13)

# --- Foot (part of the back) ---
SEN = (55.0, 26.0, 21.2)             # SEN66: length (X), width (Y), depth (Z)
SEN_X0 = 4.0
SEN_Z0 = GLASS_T + LIP + 3.3         # in front of it: the glass, the flex and 3 mm for its wires
FOOT_X0, FOOT_X1 = 0.0, X1 - 5.0        # inset from the frame's sides, leaving room for the corner screws
FLOOR = 2.4                          # foot floor thickness (rubber feet sit in it)
T_FOOT = SEN_Z0 + SEN[2] + 0.2 + WALL
SFA = (17.3, 15.2, 3.6)              # SFA40 carrier board, 16.9 x 14.8 x 3.4 measured, plus 0.2 to 0.4 clearance: X, Y, Z
STRIP_X0 = BOARD_END - 17.0           # a plate strip behind the board's right-hand end backs its foam tape there;
                                     # the foot is open behind the rest of the board, for loading it
SFA_X0 = STRIP_X0 + 1.5 - SFA[0]     # the SFA40 sits against the back wall, reachable through the opening
SFA_RECESS = 0.6                     # a shallow pocket in the wall locates it; foam tape holds it

# --- Screws: 4 x M2 x 6 (thread-forming / PT, or plain M2 into the printed hole) ---
SCREW_PILOT = 1.7
SCREW_CLEAR = 2.4
SCREWS = [(X0 + 2.5, Y0 + 2.3), (X1 - 2.5, Y0 + 2.3), (X0 + 2.5, GLASS_H - 1.5), (X1 - 2.2, GLASS_H + 1.6)]   # the last one clears the board's end
COLUMN_R = 2.3

# --- Built-in buttons: a finger in the wall's outer skin, fixed at one end, lying 0.3 mm above the
# front plate so it prints face down without support (its first layer goes over the plate, not air).
# A pad on its outer face is what you press; a nub on its inner face reaches the switch. 8 mm long
# and 0.7 thick, it moves the 0.3 mm a switch needs with about 0.7 N. ---
FINGER_L = 8.0                       # along the wall, root to free end
FINGER_T = 0.7                       # thick
FINGER_Z = (LIP + 0.3, LIP + 2.3)    # across the wall's height: covers the actuators at Z 2.0 to 2.8
SLIT = 0.6                           # past the free end and above the finger
PAD = (2.5, 0.6)                     # the pad: length along the wall, how far it stands proud
NUB_W = 1.6                          # the nub, along the wall: narrower than the 1.9 mm actuator
NUB_TOP = 2.8                        # the nub runs from the finger's underside up to here
NUB_SHORT = 0.15                     # the nub stops this short of the actuator
NUB_FROM_END = 2.0                   # the switch's centre, measured from the finger's free end


# ---------------------------------------------------------------------------------------------
def box(x0, x1, y0, y1, z0, z1):
    return Manifold.cube([x1 - x0, y1 - y0, z1 - z0]).translate([x0, y0, z0])


def rr(x0, x1, y0, y1, r):
    r = min(r, (x1 - x0) / 2 - 0.01, (y1 - y0) / 2 - 0.01)
    return CrossSection.square([x1 - x0 - 2 * r, y1 - y0 - 2 * r]).translate([x0 + r, y0 + r]).offset(
        r, JoinType.Round, circular_segments=SEG)


def prism(section, z0, z1):
    return section.extrude(z1 - z0).translate([0, 0, z0])


def zcyl(x, y, z0, z1, r):
    return Manifold.cylinder(z1 - z0, r, circular_segments=SEG).translate([x, y, z0])


def union(parts):
    return Manifold.batch_boolean(parts, OpType.Add)


# local -> world: lean back, then put the bottom front edge on the desk at Y = 0
_d = np.array([0, -math.sin(TILT), -math.cos(TILT)])   # down the face
_n = np.array([0, math.cos(TILT), -math.sin(TILT)])    # into the frame
_O = -Y1 * _d
TO_WORLD = np.c_[[1, 0, 0], _d, _n, _O]
TO_LOCAL = np.linalg.inv(np.vstack([TO_WORLD, [0, 0, 0, 1]]))[:3]


def world(m):
    return m.transform(TO_WORLD)


def local(m):
    return m.transform(TO_LOCAL)


def above_desk(m, z=0.0):
    """Cuts a local-frame part level with the desk (world Z >= z), returned in the local frame."""
    return local(world(m) ^ box(-1000, 1000, -1000, 1000, z, 1000))


# ---------------------------------------------------------------------------------------------
def outline(z0, z1):
    return prism(rr(X0, X1, Y0, Y1, RADIUS), z0, z1)


def finger(along, inward, tip, c, root_side=-1):
    """One built-in button, with the switch at c along the wall. Returns (cut, add).
    `along(u0, u1, v0, v1, w0, w1)` makes a box in frame coordinates from u along the wall, v from
    the wall's outer face inward, and w across its height (Z). root_side: -1 fixes the finger at the
    lower-u end, +1 at the higher."""
    z0, z1 = FINGER_Z
    if root_side < 0:
        u_root, u_free = c - (FINGER_L - NUB_FROM_END), c + NUB_FROM_END
        w0, w1 = u_root, u_free + SLIT
    else:
        u_root, u_free = c + (FINGER_L - NUB_FROM_END), c - NUB_FROM_END
        w0, w1 = u_free - SLIT, u_root
    # the window: through the wall to the pocket, down to the front plate and SLIT above the finger
    cut = along(w0, w1, -1.0, inward + 0.01, LIP - 0.01, z1 + SLIT)
    cut -= along(min(u_root, u_free) - 1, max(u_root, u_free) + 1, -1.0, FINGER_T, z0, z1)   # the finger
    cut += along(w0 - 1 if root_side > 0 else w1 - 0.01, w0 + 0.01 if root_side > 0 else w1 + 1, -1.0, FINGER_T, z0 - 0.01, z1 + 0.01) ^ along(w0, w1, -1.0, inward, LIP - 0.01, z1 + SLIT)   # the slit past the free end
    nub = along(c - NUB_W / 2, c + NUB_W / 2, FINGER_T - 0.01, tip - NUB_SHORT, z0, NUB_TOP)
    pad = Manifold.batch_hull([along(c - PAD[0] / 2, c + PAD[0] / 2, -0.01, 0.0, z0, z1),
                               along(c - PAD[0] / 2, c + PAD[0] / 2, -PAD[1], 0.0, z0 + PAD[1], z1)])
    return cut, nub + pad


def key_finger(x):
    """Top wall: u = x, v from the outer face at Y0 inward (+y), w = z."""
    along = lambda u0, u1, v0, v1, w0, w1: box(u0, u1, Y0 + v0, Y0 + v1, w0, w1)
    return finger(along, -CLEAR_Y - Y0, KEY_TIP_Y - Y0, x)


def pwr_finger():
    """Right wall: u = y, v from the outer face at X1 inward (-x), w = z. Fixed at its upper end."""
    along = lambda u0, u1, v0, v1, w0, w1: box(X1 - v1, X1 - v0, u0, u1, w0, w1)
    return finger(along, X1 - (BOARD_END + 0.3), X1 - PWR_TIP_X, PWR_Y)


def build_bezel():
    bez = outline(0, ZS)
    # The window, and behind it the pocket for the glass and board
    wx0, wx1 = ACTIVE_X - WINDOW_MARGIN, ACTIVE_X + ACTIVE_W + WINDOW_MARGIN
    wy0, wy1 = ACTIVE_Y - WINDOW_MARGIN_Y, ACTIVE_Y + ACTIVE_H + WINDOW_MARGIN_Y
    bez -= Manifold.batch_hull([box(wx0 - CHAMFER, wx1 + CHAMFER, wy0 - CHAMFER, wy1 + CHAMFER, -1, 0),
                                box(wx0, wx1, wy0, wy1, CHAMFER, LIP + 0.01)])
    bez -= box(X0 + WALL, X1 - 2.8, -CLEAR_Y, GLASS_H + CLEAR_Y, LIP, ZS + 1)
    # Corner columns for the screws that hold the back on
    cols = [zcyl(x, y, LIP, ZS, COLUMN_R) for x, y in SCREWS]
    bez += union(cols) ^ outline(LIP, ZS)
    bez -= box(-CLEAR, GLASS_W + CLEAR, -CLEAR_Y, GLASS_H + CLEAR_Y, LIP, ZS + 1)   # keep the pocket clear
    # and the board's end, whose tabs reach past the glass into the corner columns
    yb = BOARD_TOP + BOARD_W
    xr = BOARD_END - TAB_OUT                             # the recessed edge
    xp = xr + PWR_TAB_OUT                                # the power-switch tab's edge
    y_usb = BOARD_TOP + TAB_W                            # where the USB-C tab's step meets the recess
    y_pwr = yb - PWR_TAB_W                               # where the power tab's step meets the recess
    bez -= box(GLASS_W, BOARD_END + 0.3, BOARD_TOP - 0.3, y_usb - TAB_STEP + 0.3, LIP + GLASS_T, ZS + 1)
    bez -= box(GLASS_W, BOARD_END + 0.3, y_pwr - 0.3, yb + 0.3, LIP + GLASS_T, ZS + 1)   # generous: the power-switch tab's exact shape is uncertain
    # The nubs locate the board, across and along; the end wall is the backstop
    bez -= box(NUBS_X[0] - NUB_FIT, NUBS_X[1] + NUB_FIT, -NUB_OUT - 0.2, GLASS_H + NUB_OUT + 0.2, LIP, ZS + 1)
    # Stops at the glass's four corners, so it can't slide along X. At the right-hand end they are
    # only as thick as the glass, in front of the board.
    for y0, y1 in ((-CLEAR_Y, STOP), (GLASS_H - STOP, GLASS_H + CLEAR_Y)):
        bez += box(X0 + WALL - 0.1, -CLEAR, y0, y1, LIP - 0.01, ZS)
    # Short at the right-hand end: the USB-C socket is 2.5 mm from the top edge
    for y0, y1 in ((-CLEAR_Y, 1.5), (GLASS_H - 1.5, GLASS_H + CLEAR_Y)):
        bez += box(GLASS_W + CLEAR, GLASS_W + 1.5, y0, y1, LIP - 0.01, LIP + GLASS_T - 0.1)
    # The end wall is plain: the USB-C tab, the board's longest reach, rests against it (fit test v9),
    # and the rest of that edge has clearance. (A wall shaped to the tabs was tried and didn't fit.)
    bez -= union([zcyl(x, y, ZS - 5.5, ZS + 1, SCREW_PILOT / 2) for x, y in SCREWS])
    # Buttons on top, power on the right end, USB-C on the right end
    bez -= usb_cut()
    # The built-in buttons: cut each finger's window, then add its nub and pad
    for cut, add in [key_finger(x) for x in KEYS_X] + [pwr_finger()]:
        bez = (bez - cut) + add
    return above_desk(bez)


def usb_cut():
    front = 0.6   # keep a strip of wall along the front face
    usb = box(X1 - 3.0, X1 + 1, USB_Y - 4.8, USB_Y + 4.8, max(USB_Z - 3.5, front), ZS + 1.0)   # open at the back, so the board drops in
    plug = box(X1 - 1.2, X1 + 1, USB_Y - 6.3, USB_Y + 6.3, max(USB_Z - 4.3, front), USB_Z + 4.3)   # room for the plug's moulding
    return usb + plug


def foot_outer():
    # The shoulder between the foot and the thin back plate slopes at 45 degrees, inside and out, so
    # the back prints standing on its bottom face with no overhang
    step_y = SEN_Y0() - WALL - 0.3
    rise = T_FOOT - T_THIN
    lower = prism(rr(FOOT_X0, FOOT_X1, step_y, Y1 + 30, 2.0), ZS, T_FOOT)
    upper = prism(rr(FOOT_X0, FOOT_X1, step_y - rise, step_y - rise + 0.5, 0.2), ZS, T_THIN)
    return Manifold.batch_hull([lower, upper])


def PLATE_Y():
    """How far down the back plate reaches behind the top of the foot, just short of the SEN66."""
    return SEN_Y0() - 0.6


def SEN_Y0():
    """The SEN66's top edge, as high as needed for its bottom corner to clear the floor."""
    z_back = SEN_Z0 + SEN[2]
    # the desk cut in the local frame: y = Y1 - tan(tilt) * z
    y_floor_back = Y1 - math.tan(TILT) * z_back - FLOOR / math.cos(TILT)
    return y_floor_back - 0.5 - SEN[1]


def sensor_box():
    y0 = SEN_Y0()
    return (SEN_X0, SEN_X0 + SEN[0], y0, y0 + SEN[1], SEN_Z0, SEN_Z0 + SEN[2])


def sfa_box():
    y1 = SEN_Y0() + SEN[1] - 2
    return (SFA_X0, SFA_X0 + SFA[0], y1 - SFA[1], y1, T_FOOT - WALL - SFA[2] - 0.2, T_FOOT - WALL - 0.2)


def grille(xs, y0, y1, w=1.8):
    holes = []
    for x in xs:
        sec = CrossSection.square([w, y1 - y0 - w]).translate([x - w / 2, y0 + w / 2])
        sec = sec + CrossSection.circle(w / 2, SEG).translate([x, y0 + w / 2]) + CrossSection.circle(w / 2, SEG).translate([x, y1 - w / 2])
        holes.append(prism(sec, T_FOOT - WALL - 1, T_FOOT + 1))
    return union(holes)


def build_back():
    plate = outline(ZS, T_THIN)
    back = plate + foot_outer()
    step_y = SEN_Y0() - 0.3
    rise = T_FOOT - T_THIN
    inner_lower = prism(rr(FOOT_X0 + WALL, FOOT_X1 - WALL, step_y, Y1 + 30, 0.8), ZS - 1, T_FOOT - WALL)
    inner_upper = prism(rr(FOOT_X0 + WALL, FOOT_X1 - WALL, step_y - rise, step_y - rise + 0.5, 0.2), ZS - 1, T_THIN - WALL)
    inner = Manifold.batch_hull([inner_lower, inner_upper])
    inner = local(world(inner) ^ box(-1000, 1000, -1000, 1000, FLOOR, 1000))
    back -= inner
    # The sloped roof cuts into the plate's front skin; put the skin back down to just above the SEN66
    back += outline(ZS, ZS + WALL) ^ box(X0 - 1, X1 + 1, Y0 - 1, PLATE_Y(), ZS - 1, ZS + WALL + 1)
    # A plate strip behind the board's right-hand end, so the foam tape there has something to press
    # against. Together with the solid plate along the board's top edge it backs the board in an L,
    # and the foot stays open behind the rest of it.
    back += foot_outer() ^ box(STRIP_X0, X1, 20.0, Y1 + 30, ZS, ZS + WALL)
    # Screw holes, counterbored for the heads
    for i, (x, y) in enumerate(SCREWS):
        back -= zcyl(x, y, ZS - 1, T_THIN + 1, SCREW_CLEAR / 2)
        if i != 3:   # the bottom-right one sits too near the corner for a counterbore; its head stands proud
            back -= zcyl(x, y, T_THIN - 1.2, T_THIN + 1, 2.1)
    # SEN66: inlet (datasheet u 3.2-10.2) at its left end, fan outlet (20.5 mm circle at u 42.4)
    x0, x1, y0, y1, z0, z1 = sensor_box()
    back -= grille([x0 + 3.2 + 1.0, x0 + 6.7, x0 + 10.2 - 1.0], y0 + 2.8, y1 - 2.8)
    xc, yc, r = x0 + 42.4, y0 + 12.8, 10.6
    slots = []
    for k in range(-3, 4):
        x = xc + 3.0 * k
        h = math.sqrt(max(0.0, r * r - (abs(x - xc) + 0.9) ** 2))
        if h > 2:
            slots.append(grille([x], yc - h, yc + h))
    back -= union(slots)
    # What holds the SEN66, all printable with the back standing on its bottom face: two fins rising
    # from the floor under its bottom edge and a fin at each end, floor to back wall, each with 0.15 mm
    # interference. Its top edge sits under the plate's edge at the front and in the corner of the
    # sloped roof at the back.
    zw = T_FOOT - WALL + 0.5                     # reaches 0.5 mm into the back wall
    fins = [box(x0 + 8, x0 + 10, y1 - 0.15, y1 + 6, ZS + 1, zw),
            box(x1 - 10, x1 - 8, y1 - 0.15, y1 + 6, ZS + 1, zw),
            box(FOOT_X0 + WALL - 0.5, x0 + 0.15, y0 + 14, y1 + 6, ZS + 1, zw),
            box(x1 - 0.15, x1 + 1.85, y0 + 14, y1 + 6, ZS + 1, zw)]
    back += above_desk(union(fins), FLOOR - 0.1)
    # SFA40: a shallow recess in the back wall locates its carrier board (stuck in with foam tape),
    # and its grille is in the middle of the recess
    sx0, sx1, sy0, sy1, sz0, sz1 = sfa_box()
    back -= box(sx0, sx1, sy0, sy1, sz1 - 0.01, sz1 + SFA_RECESS)
    back -= grille([sx0 + 4 + 2.8 * k for k in range(4)], sy0 + 3, sy1 - 3, 1.5)
    # The USB-C opening reaches into the back plate
    back -= usb_cut()
    # Two ribs reach forward from the plate to hold the backing plate against the panel, with a
    # 45 degree underside so they print standing up
    zb = LIP + GLASS_T + 0.05 + BACKER_T + 0.15
    for x in BACKER_RIBS_X:
        back += Manifold.batch_hull([box(x - 1, x + 1, 9.0, PLATE_Y() - 1.0, ZS - 0.01, ZS + 0.5),
                                     box(x - 1, x + 1, 9.0, PLATE_Y() - 1.0 - (ZS - zb), zb, zb + 0.01)])
    # Level with the desk, and recesses for 10 mm rubber feet (2 mm thick, they stand 0.6 mm proud)
    w = world(back) ^ box(-1000, 1000, -1000, 1000, 0, 1000)
    for fx in (FOOT_X0 + 8, FOOT_X1 - 8):
        for fy in (12.0, 23.0):
            w -= Manifold.cylinder(1.4, 5.25, circular_segments=SEG).translate([fx, fy, -0.01])
    return local(w)


def build_backer():
    """In place behind the glass; printed flat (front face down). It drops into the pocket with
    0.1 mm to spare each side; the back's ribs hold it against the panel."""
    z0 = LIP + GLASS_T + 0.05
    plate = box(BACKER_X[0], BACKER_X[1], -CLEAR_Y + 0.1, GLASS_H + CLEAR_Y - 0.1, z0, z0 + BACKER_T)
    plate -= box(BACKER_X[1] - BACKER_NOTCH, BACKER_X[1] + 1, FLEX_Y[0] - 1.5, FLEX_Y[1] + 1.5, z0 - 1, z0 + BACKER_T + 1)   # room for the flex to rise
    plate -= box(BACKER_X[0] - 1, BACKER_X[1] + 1, FLEX_Y[0] - 1, FLEX_Y[1] + 1, z0 - 1, z0 + 0.5)   # clear of the flex strip
    return plate


def build_fit_test(bezel):
    ring = bezel ^ box(-1000, 1000, -1000, 1000, -1, 2.4)
    corner = bezel ^ (box(KEYS_X[0] - 8, 1000, -1000, 12, -1, 100) + box(X1 - 16, 1000, -1000, 1000, -1, 100))
    return ring + corner


# ---------------------------------------------------------------------------------------------
def to_trimesh(m):
    mesh = m.to_mesh()
    return trimesh.Trimesh(vertices=np.asarray(mesh.vert_properties)[:, :3], faces=np.asarray(mesh.tri_verts))


def on_bed(m, flip=False):
    t = to_trimesh(m)
    if flip:
        t.apply_transform(trimesh.transformations.rotation_matrix(math.pi, [1, 0, 0]))
    t.apply_translation(-t.bounds[0])
    return t


def main():
    ap = argparse.ArgumentParser(description=__doc__, formatter_class=argparse.RawDescriptionHelpFormatter)
    ap.add_argument("--out", default="stl")
    args = ap.parse_args()
    os.makedirs(args.out, exist_ok=True)
    bezel, back, backer = build_bezel(), build_back(), build_backer()
    fit = build_fit_test(bezel)
    back = world(back)   # printed standing on its bottom face, which is level with the desk
    for name, part, flip in (("frame_bezel", bezel, False), ("frame_back", back, False),
                             ("frame_backer", backer, False), ("frame_fit_test", fit, False)):
        print(f"{name}: {part.volume():.0f} mm^3, {part.status()}, genus {part.genus()}")
        on_bed(part, flip).export(os.path.join(args.out, name + ".stl"))
    w = world(bezel) + back
    bb = w.bounding_box()
    print(f"assembled: {bb[3] - bb[0]:.1f} wide, {bb[4] - bb[1]:.1f} deep, {bb[5] - bb[2]:.1f} tall")


if __name__ == "__main__":
    main()
