Aryeh95/PaperAir/(commit log)

2026-10-18 PaperAir: air quality display for the M5Stack PaperDIY
    A plain-words air quality display: one sentence on what to do, the
    reading behind it with its last 24 hours, and the other readings in a
    row along the bottom.
    - lib/air: US AQI (2024 breakpoints), EPA PurpleAir correction,
    humidity compensation, PurpleAir and AirNow parsing, 24-hour history,
    Sensirion protocol checks and the advice, with native unit tests
    - lib/ui: the main and trends screens drawn with M5GFX, using Fraunces
    and Manrope (OFL) converted to smooth bitmap fonts
    - src: SEN66 and optional SFA40 drivers over M5Unified's I2C, Wi-Fi,
    outdoor air from PurpleAir with AirNow as fallback, buttons and the
    e-paper refresh p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
    [config.h, main.cpp, outdoor.cpp, outdoor.h, secrets.example.h]
2026-10-18 Add a desk stand that holds the SEN66 and SFA40
    A low base the PaperDIY stands in (leaning back 12 degrees, buttons on
    top), with the SEN66 against the back wall behind two grilles, a
    slide-in SFA40 bay at the left end, and a groove and spine that carry
    the FPC cable from the PaperDIY's back into the base. The front of the
    base steps down so it doesn't hide the bottom row of the screen.
    make_stand.py generates the base, bottom plate and spine; given
    M5Stack's enclosure model it also writes their back plate with a slot
    for the FPC cable. The README covers printing, hardware and wiring.
    [stand_base.stl, stand_bottom.stl, stand_spine.stl]
2026-10-18 Show the FPC cable, breakout, capacitor and wires in the stand README
2026-10-26 Fix boot loop: give the sensors M5Unified's I2C bus itself
    The sensor objects were constructed with M5.In_I2C, a reference member
    of the M5 object. Globals in different files are constructed in no
    fixed order, so they could be built before M5 and keep an empty
    reference; the first I2C command (looking for the SFA40 at startup)
    then crashed and the board restarted over and over. Use the bus object
    m5::In_I2C, which that reference points to, instead.
    [main.cpp]
2026-10-26 Add a slim frame for the bare PaperDIY board and panel
    A thin printed frame around the panel, without M5Stack's case: the
    glass sits behind a printed lip, the board's buttons and power switch
    press through printed caps, and a foot at the bottom-back holds the
    SEN66, SFA40, FPC breakout and battery. Two printed parts held by four
    M2 screws, plus the caps.
    make_frame.py generates the parts and a quick fit test (the bezel's
    front ring plus its top-right corner at full depth) to check the lip,
    pocket, buttons and USB-C opening before printing the rest. Board
    feature positions come from photos and calipers and are listed at the
    top of the script.
    [frame_back.stl, frame_bezel.stl, frame_caps.stl, frame_fit_test.stl]
2026-10-27 Slim frame: add a backing plate for the flexible panel
    The PaperDIY's panel is flexible, and without M5Stack's acrylic plate
    nothing held the part to the left of the board flat. A flat printed
    plate now sits behind it, clipped into grooves in the bezel's pocket
    walls, with a channel over the panel's own flex strip.
    [frame_backer.stl, frame_bezel.stl, frame_fit_test.stl]
2026-10-27 Slim frame: button caps that print without overhangs
    The caps had a flange wider than the stem on all sides and a smaller
    nub, so every orientation overhung. They now have one cross-section
    along their whole length (stem, flange and a full-width ridge that
    presses the switch) and print standing on end. The flange still
    catches above and below the opening, and the openings were narrowed
    to match.
    [frame_bezel.stl, frame_caps.stl, frame_fit_test.stl]
2026-10-27 Slim frame: button, power and USB-C positions from the fit test
    Measured on a printed fit test with the board in place: the buttons
    sit about 2.5 mm closer to the USB-C end than estimated from photos,
    the power switch 1.5 mm higher and the USB-C 0.5 mm higher. Moves the
    cap openings and the USB-C opening to match.
    [frame_back.stl, frame_bezel.stl, frame_fit_test.stl]
2026-10-27 Slim frame: recesses for the nubs on the board's long edges
    The board is 64.2 mm across at two nubs near its end (M5Stack's drawing),
    which stopped it dropping into the 62.5 mm pocket.
    [frame_bezel.stl, frame_fit_test.stl]
2026-10-27 Slim frame: centre the USB-C and power switch openings on the fit test
    Both sat about 0.8 mm too far towards the top edge. The USB-C is also
    nearer the front than measured before (M5Stack's drawing gives 3 mm behind
    the glass face), and its opening now stays open at the back.
    [frame_back.stl, frame_bezel.stl, frame_fit_test.stl]
2026-10-27 Slim frame: cap openings that print without long bridges
    The openings had a flat 6.8 mm top, which sagged printed face down. They now
    have a 45 degree roof leaving a 2.6 mm bridge, the caps are 5 mm long rather
    than 6.4, and the flange recesses inside are open at the back.
    [frame_bezel.stl, frame_caps.stl, frame_fit_test.stl]
2026-10-27 Slim frame: hold the glass in place, and match the board's real position
    The glass could slide 5 mm along the pocket, and in fit test v5 it sat about
    2 mm towards the board, showing the inactive border at the flex end. Corner
    stops now hold it in place. The board, joined to the panel only by its flex,
    rests against the right-hand wall about 3 mm past the glass, so its features
    are measured from its end and the frame is 1.8 mm shorter.
    Also: the top buttons' openings 0.5 mm nearer the front and the power switch's
    0.8 mm lower (fit test v5), shorter caps to suit, and a backing plate that
    reaches 0.3 mm into its grooves with a bevel, so it clicks in.
    [frame_back.stl, frame_backer.stl, frame_bezel.stl, frame_caps.stl, frame_fit_test.stl]
2026-10-27 Slim frame: window and board positions from M5Stack's case and drawings
    The picture sits 1.5 mm from the glass's flex end and 4 mm from its board
    end; the frame had that the wrong way round, which showed a band of border at
    the board end. The window is now the picture plus 0.15 mm with a chamfered
    edge, as in the stock case. The board's end is 4.46 mm past the glass, and
    its button, USB-C and power switch positions come from M5Stack's model,
    measured from that end. The nub recesses are tighter across, so the nubs
    locate the board as they do in the stock case.
    [frame_back.stl, frame_backer.stl, frame_bezel.stl, frame_fit_test.stl]
2026-10-27 Slim frame: switch openings 0.5 mm nearer the front (fit test v7)
    [frame_bezel.stl]
2026-10-27 Slim frame: regenerate the remaining STLs
    [frame_fit_test.stl]
2026-10-27 Slim frame: the wide border is at the flex end, and room for the flex stub
    Fit test v8 measured: 4 mm of border showing at the flex end and 3.8 mm of
    the picture hidden at the board end. So the picture is 4 mm from the flex
    end, as the first design had it, not 1.5 mm as read from the stock case.
    The stiff part of the flex, 4.8 mm past the glass, was also hitting the left
    wall before the glass reached its stops; the wall is now 2 mm further out.
    [frame_back.stl, frame_backer.stl, frame_bezel.stl, frame_fit_test.stl]
2026-10-27 Slim frame: lip overlaps the picture by 0.3 mm, USB-C opening centred
    Fit test v9: the glass sits with no play along its length and a little
    across, and a thin line of the panel's black border showed on all sides
    through the 0.15 mm window margin. The lip now overlaps the picture by
    0.3 mm, within the screen's own margin. The USB-C opening moves 0.25 mm
    toward the bottom edge to centre on the socket.
    [frame_back.stl, frame_bezel.stl, frame_fit_test.stl]
2026-10-27 Slim frame: button openings 0.3 mm toward the flex end (fit test v9)
    [frame_bezel.stl, frame_fit_test.stl]
2026-10-27 Slim frame: SFA40 bay sized to the carrier board (16.9 x 14.8 x 3.4)
    [frame_back.stl]
2026-10-27 Slim frame: a plate behind the whole board, and 2 mm foam tape for it
    The foot cavity was open behind the board's lower half, so the foam tape
    had nothing to press against there and the board could lift off the glass.
    The back now keeps a 1.6 mm plate behind the board over its full height.
    [frame_back.stl]
2026-10-28 Slim frame: exploded view in the README
2026-10-28 Slim frame: a back that prints standing up, open behind the board
    As exported, the back lay on its split face, which made the whole back wall
    a 105 x 30 mm ceiling over the foot, and the SEN66 ribs 19 mm free-standing
    posts. It now prints standing on its bottom face, with a 45 degree shoulder
    between the foot and the plate inside and out, so nothing overhangs. The
    SEN66 is held by fins that rise from the floor and the corner of the roof.
    The plate behind the board had closed off the right-hand half of the foot,
    so the SFA40, battery and breakout could not be loaded. The plate now backs
    the board only along its top edge and right-hand end; the rest is an opening
    into the foot, with the SFA40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
    [frame_back.stl]
2026-10-28 Slim frame: pocket 0.2 mm narrower, more lip over the picture, drop-in backing plate
    Fit test v10: a little play across the glass, and the panel's border still
    showed top and bottom. The pocket is now 62.3 across (0.15 clearance) and
    the lip overlaps the picture by 0.5 mm top and bottom. The backing plate no
    longer clips into grooves (it was too wide to bow in); it drops into the
    pocket and two ribs on the back hold it against the panel.
    [frame_back.stl, frame_backer.stl, frame_bezel.stl, frame_fit_test.stl]
2026-10-28 Slim frame: nub recesses that locate the board along the frame
    [frame_bezel.stl, frame_fit_test.stl]
2026-10-28 Slim frame: room for the flex to rise, and the board's chamfered corner filled
    The backing plate ran up to the board, so the flex's stiff end, which rises
    to the connector on the back of the board, lifted the plate's corner. The
    plate now stops 7 mm short of the board over the flex. The corner column
    fills the board's 3 mm chamfer at the power switch.
    [frame_backer.stl, frame_bezel.stl, frame_fit_test.stl]
2026-10-28 Slim frame: the end wall follows the board's tab
    The board's end has a 15 mm tab at the USB-C corner, 3 mm proud of the rest,
    with a 45 degree step (calipers). The end wall now follows it, so the tab
    locates the board along the frame on two faces. The power switch is on the
    recessed part, 3 mm further from the wall than assumed, so its cap's ridge
    is 3 mm longer. The nub recesses go back to a generous fit.
    [frame_bezel.stl, frame_caps.stl, frame_fit_test.stl]
2026-10-28 Slim frame: tab 4 mm proud (calipers)
    [frame_bezel.stl, frame_caps.stl, frame_fit_test.stl]
2026-10-28 Slim frame: buttons built into the bezel's walls
    Three fingers cut into the top and right-hand walls, each fixed at one end
    with 0.6 mm slits around the other sides, a pad outside and a nub inside
    that reaches its switch. They replace the loose caps, which were hard to
    keep in place. The nub is narrower than the switch actuator, so it can't
    land on the switch body. The fingers run along the walls, so they print
    face down with the rest of the bezel; the windows bridge 10 mm.
    [frame_bezel.stl, frame_caps.stl, frame_fit_test.stl]
2026-10-28 Slim frame: fingers fixed at both ends, and a tab at each corner of the board's end
    The fingers fixed at one end drooped in the print: their first layer was in
    mid-air. Fixed at both ends it prints as a bridge. The power finger sits in
    a 2 mm dish in the end wall, so its nub is as short as the others.
    The board's end has a tab at both corners (calipers): the USB-C tab 4 mm
    proud, the power-switch tab 3 mm, with a recess between. The wall now
    follows all of it; before, it only allowed for the USB-C tab, and the
    power-switch tab could not go in.
    The fit test's full-depth region now reaches 16 mm from the end, so both
    nub recesses are in it.
    [frame_bezel.stl, frame_fit_test.stl]
2026-10-28 Slim frame: nubs set from the actuators, 1.5 mm past the board's edge (calipers)
    [frame_bezel.stl, frame_fit_test.stl]
2026-10-28 Slim frame: clear the board's tabs from the corner columns; move the bottom-right screw
    [frame_back.stl, frame_bezel.stl, frame_fit_test.stl]
2026-10-28 Slim frame: plain end wall again
    The wall shaped to the board's end tabs did not fit: below the USB-C the
    board's edge runs straight on where the wall came in 4 mm. The end wall is
    plain again, as in fit test v9, which fit. The USB-C tab rests against it;
    the rest of that edge has clearance, including generous cuts in the corner
    columns, and the bottom-right screw moves a little further into its corner.
    [frame_back.stl, frame_bezel.stl, frame_fit_test.stl]
2026-10-28 Slim frame: button fingers fixed at one end, lying on the front plate
    Fixed at both ends, a 9 x 0.8 mm finger needed about 20 N for the 0.3 mm a
    switch travels, so the buttons could not be pressed, and its nub hung in
    the air off a bridged layer. Each finger is now a cantilever, 8 mm long and
    0.7 thick, lying 0.3 mm above the front plate so it prints face down over
    the plate; its nub runs from its underside up, so that prints too. About
    0.7 N to click. The windows are 8.6 x 2.9 mm.
    [frame_bezel.stl, frame_fit_test.stl]
2026-10-28 Saddle: a one-piece stand with the sensor foot, for the PaperDIY in M5Stack's case
    M5Stack's bezel, back plate and caps are used as they are, so the panel,
    board and buttons fit by their design. The back plate gets an 11 x 12 mm
    slot over the board's I2S connector (cut from M5Stack's model with --oem;
    nothing of theirs is in the repo), so the FPC cable leaves straight out the
    back into a groove in the saddle and on into the foot. The foot is the slim
    frame's, with the SEN66, SFA40, breakout and battery.
    [saddle.stl]
2026-10-28 Turn off the red power LED on the back (config::kPowerLed)
    It's the M5PM1's power indicator, on by default. Off unless asked for.
2026-10-29 Keep the 24-hour history across restarts, and flip the screen by default
    The history is saved to flash (NVS) every 5 minutes once the clock is set,
    and loaded at boot with empty periods for the time the device was off.
    kFlipScreen defaults to true, which both enclosures need. Also adds the
    display diagnostic environment (pio run -e diag).
    [config.h, diag_main.cpp, main.cpp]
2026-10-29 Saddle: the cable slot where the I2S cable actually runs
    [saddle.stl]
2026-10-29 Saddle: M5Stack's bezel with a 2 mm wider lip (--lip)
2026-10-29 Saddle: pick the assembled copy of M5Stack's parts
2026-10-29 Saddle: two M2 inserts and countersunk screws through the back plate hold the case in
    [saddle.stl]
2026-10-29 Saddle: M3 inserts and screws instead of M2
    [saddle.stl]
2026-10-29 Add the web page, JSON API and a setup hotspot with a settings page
    A dashboard served by the PaperDIY at http://paperair.local/ behind a
    password: the advice, every reading with its status and a sparkline, a
    24-hour chart with hover, ranges and the watch/act levels, outdoor AQI,
    device state, and buttons to refresh the screen, switch its page,
    download the history as CSV and restart. /api/now and /api/history give
    the same data as JSON (bearer token). Light and dark, phone and desktop.
    Settings now live in flash and can be changed on /settings: Wi-Fi (with
    a scan), the PurpleAir and AirNow keys, units, clock, time zone,
    temperature offset and the web password. secrets.h is optional and onl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
2026-10-29 Settings: static IP address and mesh roaming
    A static IP, subnet, gateway and DNS can be set on the settings page
    (DHCP otherwise); they are applied before every join. On mesh networks
    with several access points of the same name, the PaperDIY now scans and
    joins the strongest one, and every 5 minutes while the signal is below
    -70 dBm it looks for one at least 8 dB stronger and moves to it. The
    device card on the web page shows the access point and channel.
2026-10-29 Firmware updates over Wi-Fi, with rollback
    Two ways to update without the cable: "pio run -e paperdiy-ota -t
    upload" (ArduinoOTA on port 3232, the web password as the OTA
    password, paperair.local or PAPERAIR_HOST) and a Firmware card on the
    settings page that takes a firmware.bin from the browser with a
    progress bar. The device card and footer show the version and build.
    A new firmware boots pending and is confirmed after it has answered a
    web request and run for 30 s, or after 5 min; a crash or restart before
    that makes the bootloader go back to the previous one. The previous
    firmware stays in the other slot and "Boot the previous firmware" on
    the settings page restarts into it.
    [main.cpp, ota.cpp, ota.h, version.h, web.cpp, web_page.h]
2026-10-30 Saddle: open underneath, with a screwed bottom plate
    The foot was closed on every side, so the sensors could not go in. It
    is now open underneath and closed by a 2 mm plate with four countersunk
    M3 screws into M3 x 3 inserts in two beams that bridge the foot between
    the SEN66 and the SFA40. The plate carries the two posts the SEN66 rests
    on and the rubber-feet pockets. make_saddle.py writes saddle_bottom.stl
    beside saddle.stl; the bezel, back plate and caps are unchanged.
    [saddle.stl, saddle_bottom.stl]
2026-10-30 Saddle: back plate holes were mirrored; slot lower; screws clear of M5Stack's openings
    M5Stack's model was mapped into the case frame with a mirror instead of
    a half turn, so the slotted back plate's screw holes landed on the
    board side, opposite the saddle's inserts. The cable slot moves 3 mm
    down and grows 2 mm, and the screws move to (14, 27) and (36, 27),
    clear of the plate's own openings. --screws puts the holes elsewhere
    for a saddle already printed.
    [saddle.stl]
2026-10-30 Saddle: no lip in front of the bezel
    The bezel clips onto the back plate from the front after the plate is
    screwed to the saddle, so nothing may stand in front of it. The floor's
    front edge is now flush with the bezel face; the screws hold the case.
    [saddle.stl, saddle_bottom.stl]
2026-10-30 Saddle: end rails hold the case, no case screws
    The assembled case slides down into two rails at the saddle's ends:
    an end wall and a 2.5 mm flange over the bezel's face, 25 mm up from
    the bottom. The flanges stop it tipping, the end walls stop it sliding,
    gravity and the 13 degree lean do the rest. The left rail has a slot
    for the power button's cap, which protrudes 1.2 mm; the USB-C is above
    the rails. The face bosses and the back plate's screw holes are gone.
    Checked against M5Stack's bezel and caps: seats and slides with no
    interference, a 5 degree forward tip is caught by the flanges.
    New exploded renders (the old render tooling was lost with the
    container).
    [saddle.stl, saddle_bottom.stl]
2026-11-09 Home Assistant over MQTT, with discovery
    PaperAir now connects to Home Assistant's MQTT broker (the Mosquitto
    add-on) and announces itself through MQTT discovery, so it shows up as
    one device with CO2, PM1/2.5/10, VOC and NOx index, formaldehyde (when
    an SFA40 is fitted), temperature, humidity, indoor and outdoor AQI,
    outdoor PM2.5, the advice headline, an "Air status" enum for automations
    and the Wi-Fi signal, plus buttons to refresh the screen, switch its
    page and restart. Readings go to paperair/<id>/state every 30 s;
    availability uses a last will, and the discovery configs are sent again
    when Home Assistant restarts.
    Uses the MQTT client built into ESP-IDF, so no new library. The broker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
    [main.cpp, mqtt.cpp, mqtt.h, secrets.example.h, settings.cpp, settings.h, version.h, web.cpp]
2026-11-10 Saddle: prints without supports; cable window straight behind the slot
    The bottom plate now screws on under the whole saddle instead of
    sitting inside it, so the screw bosses, the SEN66's end fins and the
    rail flanges all stand on the bed; the bridging beams are gone. Blind
    holes get conical tops and the SFA40 recess a 45 degree top edge. The
    only faces left past 45 degrees are the arched ends of the grille
    slots.
    The cable no longer runs down a 1 mm groove to an opening lower in the
    face: a window with a 45 degree top goes through the face directly
    behind the back plate's slot, into the cavity under the shoulder.
    Checked in the model: case seats and slides clear, plate and sensors
    clear,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
    [saddle.stl, saddle_bottom.stl]
2026-11-10 Saddle: thicker rails; the power cap's slot is a blind groove
    The left rail's end wall was cut through by the slot for the power
    button's cap, leaving the flange on a thin strip. The rails' end walls
    are now 3.2 mm thick and the slot is a groove on the inside that does
    not go through, so each rail is one solid piece. The flanges are 1.6 mm
    thick. The power button is covered; the firmware does not use it.
    [saddle.stl, saddle_bottom.stl]
2026-11-10 Saddle: power cap groove 2 mm further down, for margin
    [saddle.stl]
2026-11-11 Screen: update only the blocks that changed, so the whole screen no longer flashes every minute
    M5GFX's quality mode re-drives every pixel it is handed: a finished
    pixel is marked done with bit 15, so the next request for the same value
    fails the "changed?" check and goes through the eraser again. Pushing
    the whole canvas each minute therefore flashed the whole screen.
    The firmware now keeps the last pushed frame in PSRAM, compares the new
    one in 16-pixel tiles, merges changed tiles into rectangles and pushes
    each one clipped, as its own update. Only the clock, readings that moved
    and the chart flash; the hourly clean and page switches still push the
    whole screen. Firmware 1.6.
    [main.cpp, version.h]
2026-11-11 Screen: show CO2 as the main number, drop temperature and humidity
    The sensor runs warm in its enclosure and a thermometer nearby does the
    job better, so the screen no longer shows temperature or humidity, and
    the dry/humid advice is gone (its humidity was biased low by the same
    heat). When there's nothing to act on, the big number is now CO2 with
    its 24 hours beside it. Both readings still go to the web page and Home
    Assistant. Firmware 1.7.
    [version.h]
2026-11-13 VOC alerts can be turned off; the history survives restarts again
    Settings > Display has a VOC alerts switch. Off, the VOC index is still
    shown and charted but never changes the advice, and loses its
    past-the-limit mark on the screen.
    The 24-hour history (10 KB) was saved in NVS, whose 20 KB partition
    needs room for the new copy before it drops the old one, so every save
    after the first failed and a restart found only a stale copy. It now
    goes in a file on the 3.4 MB data partition (LittleFS), written beside
    the old copy and renamed over it. A history left in NVS by older
    firmware is used once and removed.
    The dashboard's device card now says why it last started (power on,
    update, crash, w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
    [main.cpp, settings.cpp, settings.h, version.h, web.cpp, web_page.h]
2026-11-14 CO2 alerts can be turned off too
    Settings > Display has a CO2 alerts switch beside the VOC one. Off, CO2
    is still the big number and still charted, but never changes the advice,
    and loses its past-the-limit mark. Firmware 1.9.
2026-11-14 OTA: make rollback actually work
    The Arduino core marks new firmware valid as soon as it boots unless the
    app defines verifyRollbackLater() returning true, so the trial period
    in ota.cpp never applied and a firmware that failed during startup
    stayed installed. Firmware 1.9.1.
    [ota.cpp, version.h]
